Richmond-Baah/cnc-wireless-transfer/hardware/filexfer-pcb/fab/rev-B/README.md

# FileXfer rev B (short case): fab files (single board, not ordered)

Generated by `tools/gen_fab.py` from the committed `filexfer-pcb.kicad_pcb` (the master; don't reroute unless the design changes). Don't edit by hand. Design notes: `docs/revB-notes.md` §3d–3e; ordering checklist §5.

| File | Use |
|---|---|
| `filexfer-revB-gerbers.zip` | Upload to JLCPCB (same content as `gerbers/`) |
| `bom-RX-jlc.csv`, `cpl-RX-jlc.csv` | Receiver build (SD block fitted): 31 placements |
| `bom-TX-jlc.csv`, `cpl-TX-jlc.csv` | Transmitter build (no SD block): 23 placements |
| `filexfer-revB.step` | Board + all parts, DNP J1/J3/SW1 included (`kicad-cli pcb export step --subst-models`). J1, J3 and D2 are placeholder boxes (`tools/gen_fp.py`), not vendor geometry |
| `gerber-check.png` | Independent raster of F.Cu / B.Cu (+ drills), F/B mask openings + silk, drawn from the gerber/drill files only |

- 2 layers, 1.6 mm FR-4, 1 oz, 18.3 × 34.9 mm (+5.1 mm module antenna overhang). Min track 0.15 mm, clearance 0.127 mm, via 0.45/0.2 mm, all vias tented.
- **J1 (USB-A plug, top), J3 (microSD, bottom) and SW1 (BOOT, bottom) are DNP:** hand-soldered. All assembled parts are on the top.
- **Order with JLC edge rails joined by mouse-bites, not V-cut.** Pad copper is ≥ 0.29 mm from the long edges, and the rails carry the fiducials.
- Check JLC's placement preview for part rotations.
- Module: ESP32-S3-MINI-1-N8 only (IO35 used; no PSRAM variants).
- Test pads (bottom): TP1 +3V3, TP2 GND, TP3 BOOT. No UART pads: flash over USB download mode.
