Richmond-Baah/cnc-wireless-transfer/hardware/filexfer-pcb/docs/stage3-notes.md

# FileXfer PCB — Stage 3 notes (pre-checks + design decisions)

Legend: **[V]** checked in the named datasheet/drawing; **[U]** unverified.

## 0. Decisions from Stage 2 (user, 2026-11-09)
- One PCB and one case length for TX and RX (the case grows). No short TX variant.
- LDL1117S33R. XKB U217 plug is primary, Molex 48037 alternate; the plug is a DNP option so the first 10 can be hand-soldered.
- SD power defaults ON (pull-up on the switch's ON pin, driven by GPIO2).
- LED: WS2812B-2020 powered from VBUS 5 V; data through SN74AHCT1G125 (GPIO48 unchanged). **Superseded: SN74LV1T125, Molex alternate dropped (see stage4-notes.md).**
- Placement: plug → SD socket → module, antenna at the far tip, keep-out clear of plug/SD metal.

## 1. LDL1117 output capacitor / ESR with ceramics [V ST DocID030319 Rev 3 §6.2]
- "The control loop of the LDL1117 is designed to work with an output ceramic capacitor"; X5R/X7R suggested.
- Input ≥ 1 µF, close to VIN. Suggested combination: **1 µF in / 4.7 µF out**.
- The stability plan (min C / ESR region) is only plotted for VOUT = 5 V and 1.2 V (Fig 20/21); **3.3 V is not plotted** [U]. Ceramic 4.7 µF X7R sits inside both plotted regions.
- Design: CIN 4.7 µF (≥ 1 µF min), COUT 4.7 µF X7R 0603/0805 at the pins.

## 2. Plug PCB thickness / height
| | Molex 48037-2100 (SD-48037-003) [V] | XKB U217-041N-4BV81 (drawing A1) |
|---|---|---|
| Specified PCB thickness | **1.60 ± 0.05 mm** (note 3) | not stated |
| Shell | 12.00 × 4.50 mm, 17.80 long | 12.00 (12.90 over latches) × 4.50, 18.75 long |
| Tail plane (= PCB top) from shell top | 3.10 mm → shell **+3.10 / –1.40** about PCB top | 1.90 from one face, 2.60 from the other → **+2.60/–1.90 or +1.90/–2.60** [U which face] |
| Shell legs | 4.80 below shell top = 1.70 below PCB top (0.1 mm through 1.6 mm) | slots, leg length [U] |
| Mounting | overhangs the PCB edge (pads 2.75 mm from the edge) | overhangs the edge (layout) |

- **Board thickness: 1.6 mm** (matches Molex; nothing in the XKB drawing conflicts).
- Off-centre check: a host receptacle mates with the plug's own shell, so PCB thickness does not move the plug relative to the receptacle. What matters is the plug versus the case/board stack:
  - Molex: plug centre +0.85 mm above PCB top; stack envelope –1.6…+3.10 (centre +0.75) → **0.1 mm off-centre**.
  - XKB: plug centre +0.35 or –0.35 mm → **≤ 0.4 mm off-centre** relative to the stack (centre +0.75 → 0.4/1.1 mm). Not significant for mating; the case nose must be centred on the plug, not on the PCB. [U until the XKB 3D model/sample confirms the seating face]
- **XKB and Molex footprints differ** (pad positions/edge distance), so the alternate is not drop-in. Rev A uses the XKB footprint; the Molex needs its own footprint/rev.
- Height budget: max(plug +3.10, module 2.4, SD 2.0) + PCB 1.6 = **4.7 mm** stack against 7.3 mm inner.

## 3. Inrush versus USB 50 µC
Limit: ≤ 10 µF effective across VBUS at attach ↔ 50 µC at 5 V (Microchip, TI ISOUSB211, USB-IF Device Capacitance ECN; secondary sources). The USB-IF test method was not read [U].

Without soft-start (everything charged within µs through the LDO's 1.5–2 A current limit):
Q = 5 V·C_VBUS + 3.3 V·C_3V3 = 5 × 4.9 µF (4.7 LDO-in + 2 × 0.1) + 3.3 × (4.7 LDO-out + 10 module + 22 bulk + 1 + 1 EN + about 0.6 decoupling + SD rail about 4.8) ≈ 24.5 + 145 ≈ **170 µC → fails** (and the module's internal caps add more [U]).

To meet 50 µC without soft-start, C_3V3 ≤ (50 – 24.5)/3.3 ≈ 7.7 µF, which is below Espressif's ≥ 10 µF at the module. **So soft-start is needed.**

Design: a second **TPS22917** (U-SS) between the LDO output (3V3_LDO) and the main rail (+3V3), ON tied to its VIN, CT = 2.2 nF (CT → VIN), QOD open.
- tR at VIN 3.6 V = 1.6 µs/pF → **≈ 3.5 ms**; tON 3.8 µs/pF → about 8.4 ms [V TI SLVSDW8B §7.6].
- Ramp ≈ 0.8·3.3 V / 3.5 ms ≈ 0.75 V/ms → inrush into about 45 µF ≈ **34 mA** (≪ 100 mA unconfigured).
- Fast charge from VBUS = 5 × 4.9 + 3.3 × 4.7 ≈ **40 µC ≤ 50 µC** (nominal values; DC-bias derating only lowers it).
- Cost: +1 × TPS22917 (about $0.29 @100), Ron 80 mΩ → 32 mV at 0.4 A.
- The SD rail sits behind its own TPS22917 (CT 1 nF → tR ≈ 1.6 ms, QOD tied to VOUT for a fast power-cycle discharge) and is fed from +3V3, so it does not draw from VBUS directly.
- The ESP32 EN RC (10 k / 1 µF) is on +3V3 (after soft-start).

## 4. LED from VBUS
- WS2812B-2020 VDD = +5V (VBUS after polyfuse), 100 nF. SN74AHCT1G125: VCC +5V, OE̅ to GND, A = GPIO48 (10 k pull-down so the LED stays dark while the ESP boots), Y → 100 Ω → DIN.
- AHCT VCC range is 4.5–5.5 V; VBUS after the fuse and cable may sag below 4.5 V under Wi-Fi peaks → the buffer runs out of spec (VIH 2.0 V stays met; output high ≈ VCC) [U, bench].
- +5V caps (2 × 100 nF) are counted in C_VBUS above.

## 5. Tooling
- KiCad 10.0.4 (kicad-cli for ERC/netlist/DRC/export). The KiCad MCP server exposes project/pcb tools only, with no schematic editing, so the schematic is **generated by a script** from KiCad stock symbols (labels on pins) and checked with `kicad-cli sch erc` + netlist comparison.
- Stock symbols: RF_Module:ESP32-S3-MINI-1 (its footprint field is RF_Module:ESP32-S2-MINI-1, the same 15.4 × 20.5 land pattern; check against DS-M Fig 11-1 in Stage 4 [U]), Regulator_Linear:LD1117S33TR_SOT223 (pinout 1 GND, 2 VOUT/tab, 3 VIN = LDL1117 SOT-223 [V]), Power_Protection:USBLC6-2SC6, Power_Management:TPS22917DBV, LED:WS2812B-2020, 74xGxx:74AHCT1G125, Connector:Micro_SD_Card_Det1, Connector:USB_A, Device:Polyfuse, Connector:TestPoint.
- Stock footprints: Connector:Tag-Connect_TC2030-IDC-NL, Button_Switch_SMD:SW_SPST_TS-1088-xR020, LED_SMD:LED_WS2812B-2020_PLCC4_2.0x2.0mm, Connector_USB:USB_A_Molex_48037-2200_Horizontal (−2200, not −2100: check). **Custom footprints needed in Stage 4:** XKB U217 plug, SHOU HAN TF PUSH.

## 6. Stage 3 result
- `filexfer-pcb.kicad_sch` is generated by `tools/gen_sch.py` (edit the script, not the file). Every symbol pin is mapped to a net or NC, and the script refuses to write otherwise.
- **ERC: 0 errors, 0 warnings** (`kicad-cli sch erc`, KiCad 10.0.4). Fixes on the way: the SD switch's QOD goes to VOUT through R24 0 Ω (datasheet option 1; clears the open-collector↔power-out conflict), symbols snapped to grid, and the `filexfer` footprint library was added.
- Netlist reviewed: 36 named nets. GND has 55 pins (24 module + 31 others).
- 63 parts. Fit field: ALL / RX (SD block: U6, J3, C13–C15, R11–R24) / DNP (C1, C2, R3). The plug J1 keeps a DNP option for hand-soldering the first 10.
- Custom footprints (`tools/gen_fp.py` → `filexfer.pretty`), parsed and plotted by kicad-cli:
  - `microSD_SHOUHAN_TF_PUSH`: 9 contact pads (pad 9 = Cd) 0.70 × 1.60 at 1.10 pitch, 4 shell pads, 2 × Ø1.00 NPTH, from the vendor recommended layout. Body Y position derived from the top view [U].
  - `USB_A_Plug_XKB_U217-041N-4BV81`: 4 × 1.20 × 2.00 SMD (7.00 span), 2 × Ø1.00 NPTH at ±2.25, 2 × plated oval 1.60 × 4.00 / drill 1.00 × 2.50 at ±5.70. **The board-edge position and whether the shell's 1.90 mm drop needs a PCB notch are not in the drawing** [U]; resolve with the vendor 3D model before layout.
- Passive LCSC numbers are not assigned yet (Stage 4 BOM step); IC/connector LCSC numbers are in symbol fields.
- Firmware board-config proposal: `firmware/board_config.h` (Super Mini + rev A pin sets, SD SPI/SDMMC on the same pins, SD power/CD, board-ID ADC windows: TX 22k → 595 mV, RX 100k → 1650 mV).

## 7. Open items carried to Stage 4
1. XKB plug seating (mid-mount drop 1.90/2.60, notch?) from the 3D model; plug centre relative to the case nose.
2. ESP32-S3-MINI-1 footprint: the stock `RF_Module:ESP32-S2-MINI-1` must be checked against DS-M Fig 11-1 (65 pads, antenna keep-out).
3. CD switch polarity (TF PUSH Cd → shell?) and SD pull-up values [U].
4. D+ pull-up value (R3, DNP) per HDG [U].
5. Firmware: before SD power-off, set the SD GPIOs to input/low so the card is not back-powered through the ESD diodes.
