Richmond-Baah/cnc-wireless-transfer/session-ses_1e20.md

# Greeting

**Session ID:** ses_1e201b6c8ffeLG4DZr5js88S0P
**Created:** 5/12/2026, 9:01:04 PM
**Updated:** 5/12/2026, 9:26:03 PM

---

## User

hello

---

## Assistant (Build · GLM5 · 210.4s)

Hello! How can I help you today?

---

## User

in this codebase i have two folders for one project(receiver and transmitter), the other folder(esp32-s3...) is a whole project on its own, tell me about the various projects

---

## Assistant (Build · GLM5 · 55.0s)

**Tool: read**

**Input:**
```json
{
  "filePath": "C:\\Users\\3FARMATE ROBOTICS\\OneDrive\\Desktop\\WORKABLE_TRANSFER\\cnc-wireless-transfer"
}
```

**Output:**
```
<path>C:\Users\3FARMATE ROBOTICS\OneDrive\Desktop\WORKABLE_TRANSFER\cnc-wireless-transfer</path>
<type>directory</type>
<entries>
esp32-s3-pendrive-wireless-usb-disk-master/
receiver/
transmitter/

(3 entries)
</entries>
```

---

## User

0

---

## Assistant (Build · GLM5 · 931.4s)

**Tool: task**

**Input:**
```json
{
  "description": "Explore all project folders",
  "prompt": "Explore the codebase at C:\\Users\\3FARMATE ROBOTICS\\OneDrive\\Desktop\\WORKABLE_TRANSFER\\cnc-wireless-transfer thoroughly. There are 3 folders: receiver, transmitter, and esp32-s3-pendrive-wireless-usb-disk-master. For each folder, I need to understand:\n\n1. What the project does (purpose)\n2. Key source files and their roles\n3. Hardware target (e.g., ESP32, Arduino, etc.)\n4. Key libraries/frameworks used\n5. Communication protocols used (WiFi, BLE, serial, etc.)\n\nRead README files if they exist, read main source files, check platformio.ini or other config files for dependencies and board settings. Provide a comprehensive summary of each project.",
  "subagent_type": "explore"
}
```

**Output:**
```
task_id: ses_1e1f9ea36ffeFX9g0Z6r0ukhR6 (for resuming to continue this task if needed)

<task_result>
Now I have all the information needed. Here is the comprehensive summary of all three projects:

---

# Comprehensive Codebase Analysis

## Overview

This workspace is a **CNC Wireless G-Code Transfer System** -- a two-device solution that lets users wirelessly upload CNC G-code files from a browser to an ESP32-S3 acting as a USB flash drive connected to a CNC machine. A third project is a reference/inspiration project from ThingPulse.

---

## 1. TRANSMITTER

**Location:** `C:\Users\3FARMATE ROBOTICS\OneDrive\Desktop\WORKABLE_TRANSFER\cnc-wireless-transfer\transmitter\`

### Purpose
The Transmitter is the **user-facing hub**. It hosts a secure web interface (served from SPIFFS) where an operator can log in, upload G-code files, and have those files streamed over Wi-Fi to the Receiver unit. It acts as an HTTP proxy between the browser and the receiver, forwarding file data in chunks without buffering the entire file in RAM.

### Hardware Target
- **ESP32-S3** (specifically the "ESP32-S3 Super Mini" board)
- 4MB Flash, custom partition table (1.5MB app, 448KB SPIFFS for web assets)
- Onboard WS2812 RGB LED on **GPIO 48**

### Framework / Build System
- **ESP-IDF** (v5.0+), CMake-based
- Project name: `cnc_transmitter`
- Language: **C**

### Key Source Files and Their Roles

| File | Role |
|------|------|
| `main.c` | Entry point. Initializes NVS, LED, Wi-Fi, SPIFFS, web server, and the background receiver-status poller. |
| `wifi_manager.c/.h` | Wi-Fi initialization. Supports **SoftAP** (default, SSID `CNC_WIRELESS`), **Station**, or **AP+STA** mode. Reads/writes credentials to NVS (`wifi_cfg` namespace). Sets AP IP to `192.168.4.1`. Disables power management (`WIFI_PS_NONE`) for reliable AP beacons. |
| `web_server.c/.h` | HTTP server (port 80). Serves static assets from SPIFFS (login page, upload page, CSS, JS, MD5 library). Handles REST endpoints: `/login` (auth), `/upload` (file relay), `/status` (receiver state), `/config` (GET/POST Wi-Fi and auth settings), `/receiver_clear`, `/upload_cancel`, `/receiver_list`, `/debug`, `/ping`. |
| `file_transfer.c/.h` | Core transfer engine. Implements the 3-phase chunked protocol: (1) `POST /prepare` to receiver with filename/size/md5, (2) streams 8KB chunks via `POST /chunk` with `X-Chunk-Index` header, (3) `POST /finalize` with computed MD5. Computes MD5 on-the-fly using mbedTLS. Also runs a **background FreeRTOS task** that polls the receiver `/status` every 2 seconds and caches the result (mutex-protected) so the web UI `/status` endpoint never blocks. Target receiver IP: `192.168.4.150` (static). |
| `auth.c/.h` | Simple session-token authentication. Validates username/password from NVS (`sys_cfg` namespace), generates a 64-char hex token from `esp_random()`, and validates it on subsequent requests via `Authorization: Bearer <token>` header. |
| `led.c/.h` | WS2812 RGB LED controller. 5 states: IDLE (white breathing), UPLOADING (slow yellow blink), SENDING (fast yellow blink), SUCCESS (solid green 5s), ERROR (solid red 5s). Runs a dedicated FreeRTOS task. |

### Web UI Assets (SPIFFS)
| File | Role |
|------|------|
| `spiffs_data/index.html` | Login page with username/password form |
| `spiffs_data/upload.html` | Main upload interface with drag-and-drop, progress bar, cancel button, receiver status badge, file list, and settings modal |
| `spiffs_data/app.js` | Client-side JavaScript for login, file upload (with client-side MD5 via spark-md5), progress tracking, settings management |
| `spiffs_data/style.css` | CSS styling |
| `spiffs_data/spark-md5.min.js` | Client-side MD5 library for integrity verification in the browser |

### Communication Protocols
- **Wi-Fi** (802.11 b/g/n): SoftAP mode (default) or STA mode
- **HTTP** (REST API): Server on port 80 for browser clients; HTTP client for communicating with the receiver
- Custom 3-phase transfer protocol over HTTP: `/prepare` -> `/chunk` -> `/finalize`

### Key Libraries/Dependencies
- `espressif/led_strip` v3.0.0 (managed component for WS2812 via RMT)
- ESP-IDF components: `nvs_flash`, `esp_wifi`, `esp_http_server`, `esp_http_client`, `mbedtls` (MD5), `spiffs`, `cJSON`, `driver`

### Default Credentials
| Setting | Value |
|---------|-------|
| Wi-Fi SSID | `CNC_WIRELESS` |
| Wi-Fi Password | `cnc12345` |
| Web Username | `admin` |
| Web Password | `admin123` |
| Receiver IP | `192.168.4.150` |

---

## 2. RECEIVER

**Location:** `C:\Users\3FARMATE ROBOTICS\OneDrive\Desktop\WORKABLE_TRANSFER\cnc-wireless-transfer\receiver\`

### Purpose
The Receiver is the **CNC-facing device**. It connects to the Transmitter's Wi-Fi network, receives G-code files over HTTP, stores them on an SD card (via SPI), and simultaneously exposes that SD card as a **USB Mass Storage device** (USB flash drive) to the CNC machine. A strict state machine ensures mutual exclusion between Wi-Fi writes and USB reads to prevent data corruption.

### Hardware Target
- **ESP32-S3** ("ESP32-S3 Super Mini" board)
- 4MB Flash, custom partition table (24KB NVS, 2MB FAT storage partition, 1280KB app)
- MicroSD Card module connected via **SPI** (SPI3_HOST)
- Onboard WS2812 RGB LED on **GPIO 48**
- Native USB-C port (used as USB Device -- not for serial)

### SD Card SPI Pinout
| SD Pin | ESP32-S3 GPIO |
|--------|---------------|
| MOSI | GPIO 11 |
| MISO | GPIO 13 |
| SCK/CLK | GPIO 12 |
| CS/SS | GPIO 10 |
| VCC | 3.3V |
| GND | GND |

### Framework / Build System
- **ESP-IDF** (v5.0+), CMake-based
- Project name: `cnc_receiver`
- Language: **C**
- CPU frequency locked at **240 MHz**; power management **disabled** for Wi-Fi STA reliability

### Key Source Files and Their Roles

| File | Role |
|------|------|
| `main.c` | Entry point. Sequential initialization: NVS -> state machine -> LED -> SD card -> Wi-Fi (STA) -> file receiver HTTP server -> USB MSC. Includes a debug task that logs heap and USB mount status every 2s. |
| `wifi_manager.c/.h` | Wi-Fi STA initialization. Connects to the Transmitter's AP (or a shared router). Applies a **static IP of 192.168.4.150** (avoiding DHCP conflicts). Implements a fallback mechanism: alternates between custom SSID and default `CNC_WIRELESS` after max retries. |
| `file_receiver.c/.h` | HTTP server (port 80) implementing the receiver side of the transfer protocol. Endpoints: `/prepare` (accept file metadata, transition to RECEIVING, disconnect USB, open file), `/chunk` (write binary data to SD), `/finalize` (verify MD5, transition to FILE_READY, flush storage, reconnect USB), `/cancel`, `/status`, `/list`, `/download/*`, `/clear`, `/format`, `/settings` (accepts Wi-Fi config forwarded from transmitter). Also serves a minimal HTML file browser. |
| `state_machine.c/.h` | Thread-safe (mutex-protected) finite state machine with 5 states: `IDLE`, `RECEIVING`, `FILE_READY`, `USB_ACTIVE`, `ERROR`. Enforces valid transitions only. Directly drives LED state changes. |
| `sd_card.c/.h` | SD card initialization via SPI3_HOST with **multi-speed diagnostics** (tries 20MHz, 10MHz, 5MHz, 1MHz, 400kHz). Provides mount/unmount/remount functions. Global `current_sd_card` pointer shared with `usb_msc.c` for raw sector access. |
| `usb_msc.c/.h` | TinyUSB Mass Storage Class implementation. Exposes the SD card (or internal flash wear-leveling partition as fallback) as a USB flash drive. Implements all TinyUSB MSC callbacks: `read10`, `write10`, `capacity`, `test_unit_ready`, `inquiry`, `scsi`. Uses DMA-capable buffers for SD sector read/write. Provides `usb_msc_disconnect()`/`usb_msc_connect()` for safe USB re-enumeration during file transfers. USB device identifies as "Generic USB Flash Drive" (VID: 0x303A, PID: 0x4002). |
| `storage_manager.c/.h` | Fallback internal flash storage using wear-leveling (`esp_vfs_fat_spiflash_mount_rw_wl`). Used if no SD card is present. Provides mount/unmount/format functions. Reports base path as `/sdcard` (if SD mounted) or `/storage` (if using internal flash). Volume label set to `FILEXFER`. |
| `led.c/.h` | WS2812 RGB LED controller. 5 states: IDLE (white breathing), RECEIVING (blinking yellow), FILE_READY (solid green), USB_ACTIVE (solid blue), ERROR (solid red 5s then auto-transitions to IDLE). |

### State Machine Diagram
```
IDLE ──────────> RECEIVING ──────> FILE_READY
  ^                  |                  |
  |                  v                  v
  |               ERROR              USB_ACTIVE
  |                  |                  |
  └──────────────────┴──────────────────┘
```

### Communication Protocols
- **Wi-Fi** (802.11 b/g/n): Station mode only, connects to the Transmitter's AP
- **HTTP** (REST API): Server on port 80, accepts file transfers from the transmitter
- **USB Mass Storage** (USB 2.0 Full Speed): Exposes SD card as a standard USB flash drive to the CNC machine
- **SPI**: Communication with the MicroSD card module

### Key Libraries/Dependencies
- `espressif/led_strip` v3.0.0 (WS2812 RGB LED via RMT)
- `espressif/esp_tinyusb` v1.4.3 (USB MSC device support)
- ESP-IDF components: `nvs_flash`, `esp_wifi`, `esp_http_server`, `fatfs`, `wear_levelling`, `sdmmc`, `esp_tinyusb`, `mbedtls` (MD5), `cJSON`, `driver`

### Critical Configuration (sdkconfig.defaults)
- `CONFIG_TINYUSB_MSC_ENABLED=y` -- TinyUSB MSC enabled
- `CONFIG_FATFS_SECTOR_512=y` -- 512-byte sectors for CNC printer compatibility
- `CONFIG_FATFS_LONG_FILENAMES=y` -- Long filename support
- `CONFIG_ESP_CONSOLE_USB_SERIAL_JTAG_ENABLED=n` -- USB Serial/JTAG disabled to free USB for TinyUSB MSC
- `CONFIG_ESP_DEFAULT_CPU_FREQ_MHZ_240=y` -- 240MHz for stable Wi-Fi
- Power management disabled (light sleep breaks Wi-Fi STA)

---

## 3. ESP32-S3 PENDRIVE WIRELESS USB DISK MASTER

**Location:** `C:\Users\3FARMATE ROBOTICS\OneDrive\Desktop\WORKABLE_TRANSFER\cnc-wireless-transfer\esp32-s3-pendrive-wireless-usb-disk-master\`

### Purpose
This is a **reference/inspiration project** from ThingPulse (commercial product: "Pendrive S3"). It implements a wireless USB disk: when plugged into a computer, it mounts as a regular memory stick AND starts a Wi-Fi access point with a web server, allowing users to access, upload, and delete files on the storage via a browser. The CNC transfer system appears to have been inspired by and adapted from this project.

### Hardware Target
- **ThingPulse Pendrive S3** (ESP32-S3 with 128MB flash, custom hardware with integrated SD card via MMC)
- Board: `esp32-s3-devkitc-1`

### Framework / Build System
- **PlatformIO** (not ESP-IDF directly)
- **Arduino framework** (not ESP-IDF native)
- Language: **C++**
- Custom platform fork: `https://github.com/cziter15/platform-espressif32.git`
- 4MB Flash, `min_spiffs` partition scheme

### Key Source Files and Their Roles

| File | Role |
|------|------|
| `src/main.cpp` | Arduino setup/loop. Initializes SD_MMC (4-bit mode on specific GPIOs: CLK=36, CMD=35, D0-D3=37/38/33/34), configures USB MSC with read/write/start-stop callbacks, starts USB, then calls `initWebServer()`. Main loop handles web server client requests and updates the NeoPixel LED (red for host writes, green for host reads, brown for both). |
| `src/fileserver.h` | Complete web server implementation. Uses Arduino `WebServer` on port 80. Features: file listing (`/api/list`), disk info (`/api/disk`), settings management (`/api/settings` GET/POST), file upload (`/upload`), file delete (`/delete`), and generic file serving from SD card. Settings (Wi-Fi mode, AP/STA credentials) stored in SPIFFS as JSON. Supports AP, STA, and AP+STA modes. **Restarts the device after file uploads** to make changes visible to the USB host. |
| `web/index.html` | Web interface for file browsing/upload |
| `web/settings.html` | Settings page for Wi-Fi configuration |
| `web/favicon.ico` | Favicon |

### Communication Protocols
- **Wi-Fi** (802.11 b/g/n): AP mode (default SSID: `wireless-usb-disk`, password: `12345678`), STA, or AP+STA
- **HTTP**: Web server on port 80 for file management
- **USB Mass Storage**: Exposes SD card as USB flash drive to host computer
- **SDMMC** (4-bit mode): High-speed SD card access (not SPI like the receiver)

### Key Libraries/Dependencies
- `USB.h` / `USBMSC.h` -- Arduino USB MSC library
- `SD_MMC.h` -- Arduino SD card MMC library
- `WiFi.h` / `WiFiAP.h` -- Arduino Wi-Fi libraries
- `WebServer.h` -- Arduino HTTP server
- `SPIFFS.h` -- Arduino SPIFFS for settings storage
- `bblanchon/ArduinoJson@^7.1.0` -- JSON parsing/serialization

### Default Credentials
| Setting | Value |
|---------|-------|
| AP SSID | `wireless-usb-disk` |
| AP Password | `12345678` |

---

## Comparative Summary

| Feature | Transmitter | Receiver | Pendrive S3 (Reference) |
|---------|------------|----------|------------------------|
| **Framework** | ESP-IDF (C) | ESP-IDF (C) | Arduino/PlatformIO (C++) |
| **Role** | Web UI hub + file proxy | File storage + USB drive to CNC | Standalone wireless USB disk |
| **Wi-Fi Mode** | SoftAP (default) / AP+STA | STA only | AP / STA / AP+STA |
| **HTTP Server** | Yes (full REST API) | Yes (transfer protocol + file browser) | Yes (file browser + upload) |
| **USB MSC** | No | Yes (TinyUSB, SD via SPI) | Yes (Arduino USBMSC, SD via MMC) |
| **SD Card** | None | Yes, SPI mode (SPI3_HOST) | Yes, MMC mode (4-bit) |
| **Internal Flash Storage** | SPIFFS (web assets) | FAT wear-leveling (fallback storage, 2MB) | Not used for data |
| **Authentication** | Session token (Bearer) | None | None |
| **MD5 Verification** | Yes (mbedTLS, on-the-fly) | Yes (mbedTLS, on-the-fly) | No |
| **State Machine** | Simple LED states | Full FSM with mutual exclusion | None |
| **LED** | WS2812 (5 states) | WS2812 (5 states) | NeoPixel (read/write indicators) |
| **File Transfer Protocol** | Custom 3-phase chunked HTTP | Receiver side of same protocol | Direct upload + device restart |
| **Chunked Streaming** | Yes (8KB chunks) | Yes (16KB buffer) | No (full file buffer) |
| **Cancel Support** | Yes (abort flag + receiver /cancel) | Yes (/cancel endpoint) | No |
| **Settings Sync** | Forwards to receiver before saving local | Accepts from transmitter | Local SPIFFS only |

### Key Architectural Differences from Reference Project

The CNC system significantly improves upon the Pendrive S3 reference design:

1. **No restart required**: The Pendrive S3 restarts the entire device after each file upload to make changes visible to the USB host. The CNC Receiver instead disconnects/reconnects USB on-the-fly (`tud_disconnect()`/`tud_connect()`), preserving network connectivity.

2. **Chunked streaming**: Instead of buffering entire files in RAM, the CNC system uses an 8KB chunked protocol, enabling transfer of files much larger than available heap memory.

3. **MD5 integrity verification**: Both transmitter and receiver compute MD5 checksums on-the-fly during transfer, verifying end-to-end integrity. The Pendrive S3 has no such verification.

4. **State machine with mutual exclusion**: The receiver enforces strict USB/Wi-Fi mutual exclusion -- USB is disconnected during file writes and reconnected after verification, preventing the CNC machine from reading partially-written data.

5. **Authentication**: The transmitter implements session-token authentication, preventing unauthorized access to the CNC file transfer system.

6. **ESP-IDF native**: The transmitter and receiver use ESP-IDF (C) rather than Arduino (C++), providing lower-level control over TinyUSB, SPI, and the Wi-Fi stack -- essential for the simultaneous Wi-Fi + USB MSC operation with state machine enforcement.
</task_result>
```

---

## Assistant (Build · GLM5 · 107.3s)

Here's a summary of the 3 projects in your workspace:

---

### 1. **Transmitter** — Web UI Hub + File Relay
- **Role**: User-facing device. Hosts a secure web interface (login, drag-and-drop upload) and streams G-code files over Wi-Fi to the Receiver in 8KB chunks.
- **Hardware**: ESP32-S3 Super Mini, WS2812 LED (GPIO 48)
- **Framework**: ESP-IDF (C), SPIFFS for web assets
- **Wi-Fi**: SoftAP mode (SSID: `CNC_WIRELESS`, IP: `192.168.4.1`)
- **Features**: Session-token auth, on-the-fly MD5 verification, background receiver status polling, REST API (`/login`, `/upload`, `/status`, `/config`, etc.)

### 2. **Receiver** — CNC-Facing USB Flash Drive
- **Role**: Connects to the Transmitter's Wi-Fi, receives G-code files over HTTP, stores them on an SD card (SPI), and exposes that SD card as a **USB Mass Storage** device to the CNC machine.
- **Hardware**: ESP32-S3 Super Mini, MicroSD via SPI (MOSI=11, MISO=13, SCK=12, CS=10), WS2812 LED
- **Framework**: ESP-IDF (C), TinyUSB for MSC, FAT filesystem
- **Wi-Fi**: STA only, static IP `192.168.4.150`
- **Features**: 5-state FSM enforcing USB/Wi-Fi mutual exclusion (disconnects USB during writes, reconnects after), MD5 verification, fallback internal flash storage, cancel support

### 3. **ESP32-S3 Pendrive Wireless USB Disk** — Reference Project (ThingPulse)
- **Role**: A standalone wireless USB disk — mounts as a flash drive on a PC *and* serves a web UI for file upload/management over Wi-Fi.
- **Hardware**: ThingPulse Pendrive S3 (ESP32-S3, 128MB flash, SD via MMC 4-bit)
- **Framework**: Arduino/PlatformIO (C++)
- **Wi-Fi**: AP/STA/AP+STA
- **Key difference**: Requires a **full device restart** after each upload (no hot USB reconnect), no MD5 verification, no chunked streaming, no state machine

---

**How they relate**: The Transmitter + Receiver are your custom CNC wireless transfer system, purpose-built to reliably stream G-code to CNC machines. The Pendrive S3 project was the inspiration/reference, but your system improves on it significantly — chunked streaming, MD5 integrity, USB hot-reconnect without restart, and a strict state machine for data safety.

---
