Richmond-Baah/cnc-wireless-transfer/hardware/filexfer-pcb/docs/img/placement-2d.png

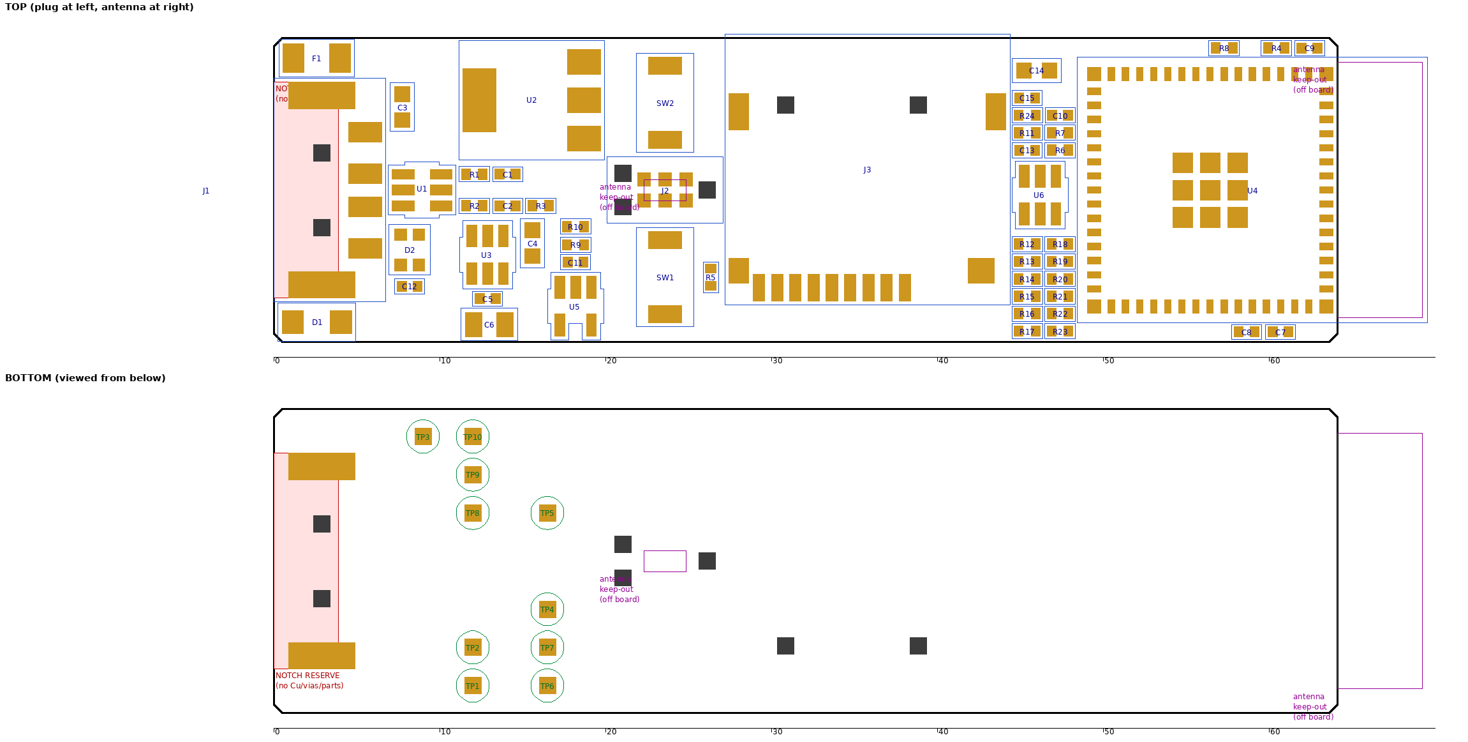
hardware/filexfer-pcb/docs/img/placement-2d.png
