Richmond-Baah/cnc-wireless-transfer/hardware/filexfer-pcb/docs/img/placement-3d-iso.png

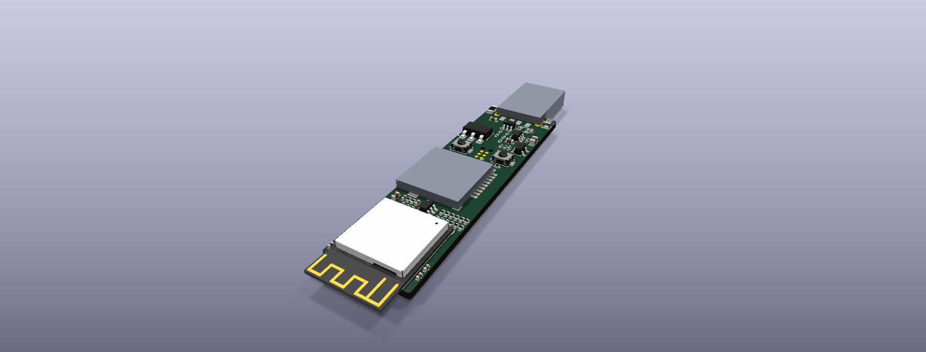
hardware/filexfer-pcb/docs/img/placement-3d-iso.png
