Richmond-Baah/cnc-wireless-transfer/hardware/filexfer-pcb/docs/img/revB-feasibility-sketch.png

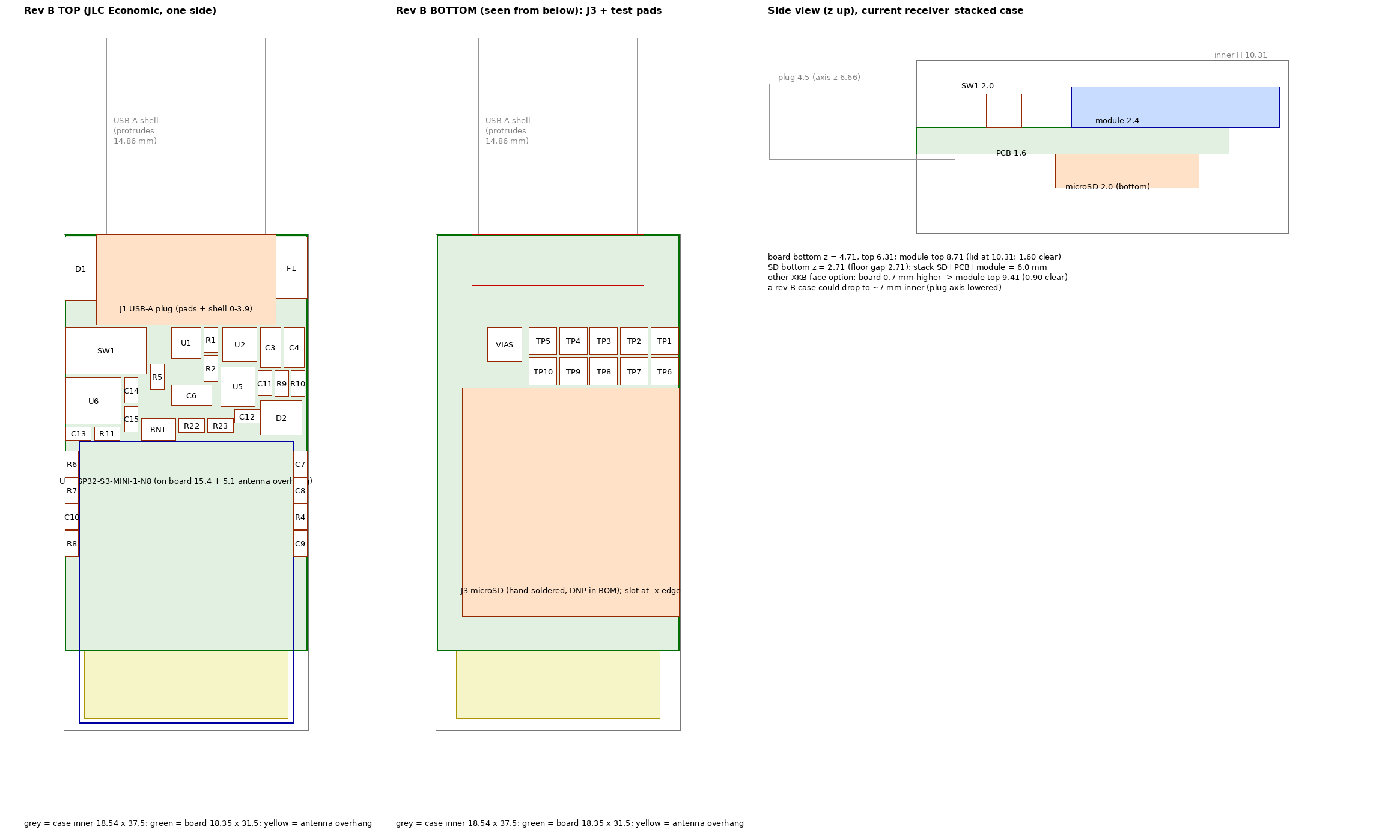
hardware/filexfer-pcb/docs/img/revB-feasibility-sketch.png
