Richmond-Baah/cnc-wireless-transfer/hardware/filexfer-pcb/docs/img/revB-placement-2d.png

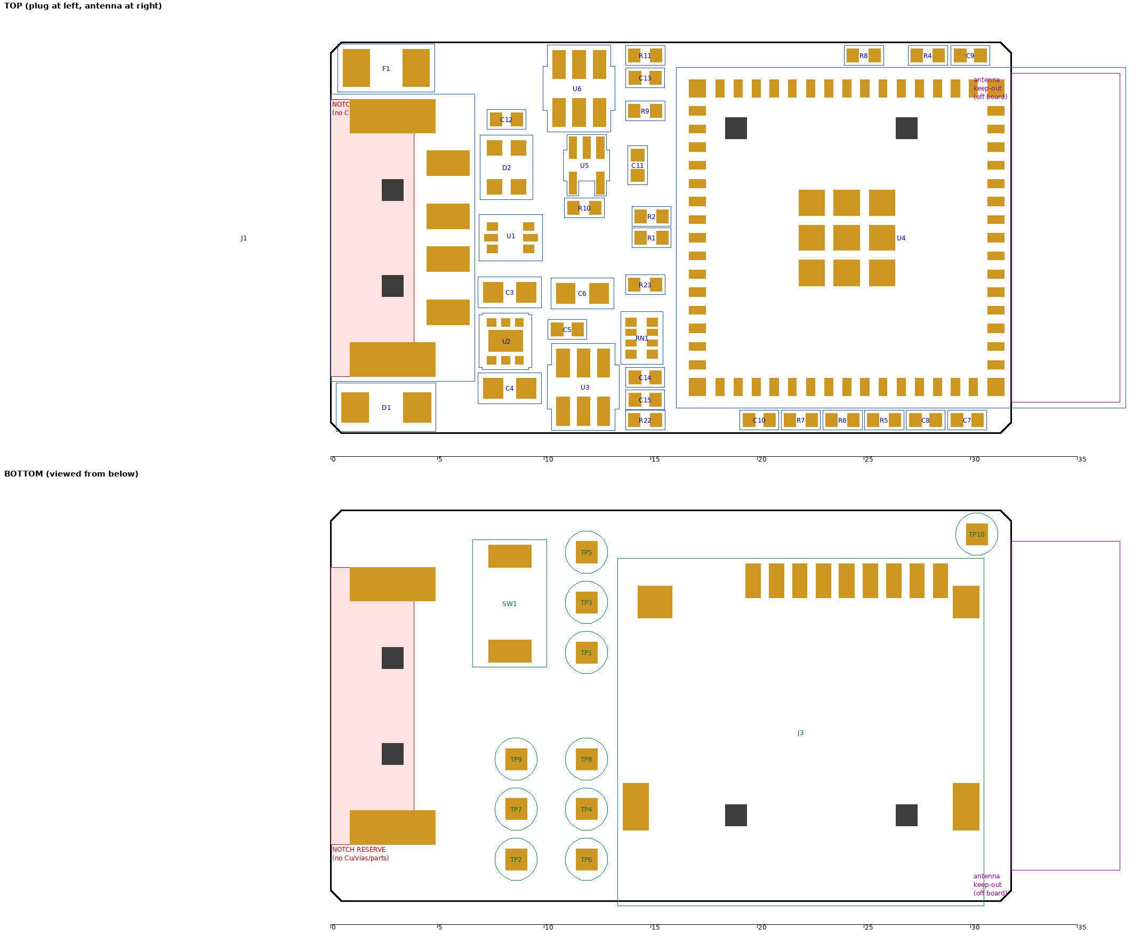
hardware/filexfer-pcb/docs/img/revB-placement-2d.png
