Richmond-Baah/cnc-wireless-transfer/hardware/filexfer-pcb/docs/img/revB-route-attempt-2layer.png

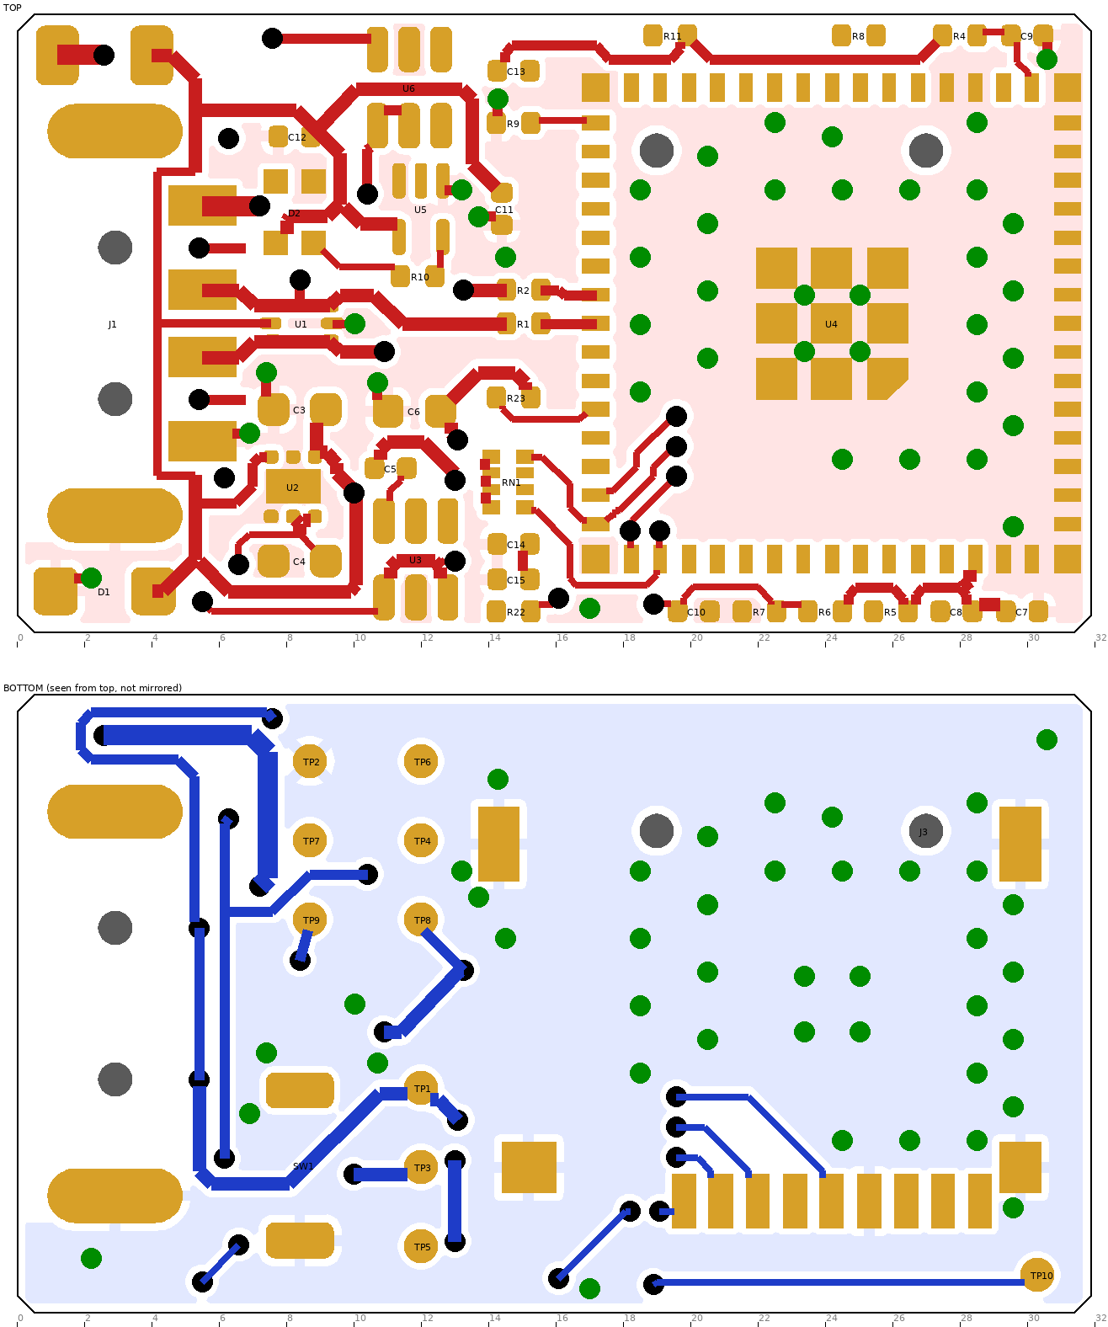
hardware/filexfer-pcb/docs/img/revB-route-attempt-2layer.png
