Richmond-Baah/cnc-wireless-transfer/hardware/filexfer-pcb/docs/img/revB-routed-2d.png

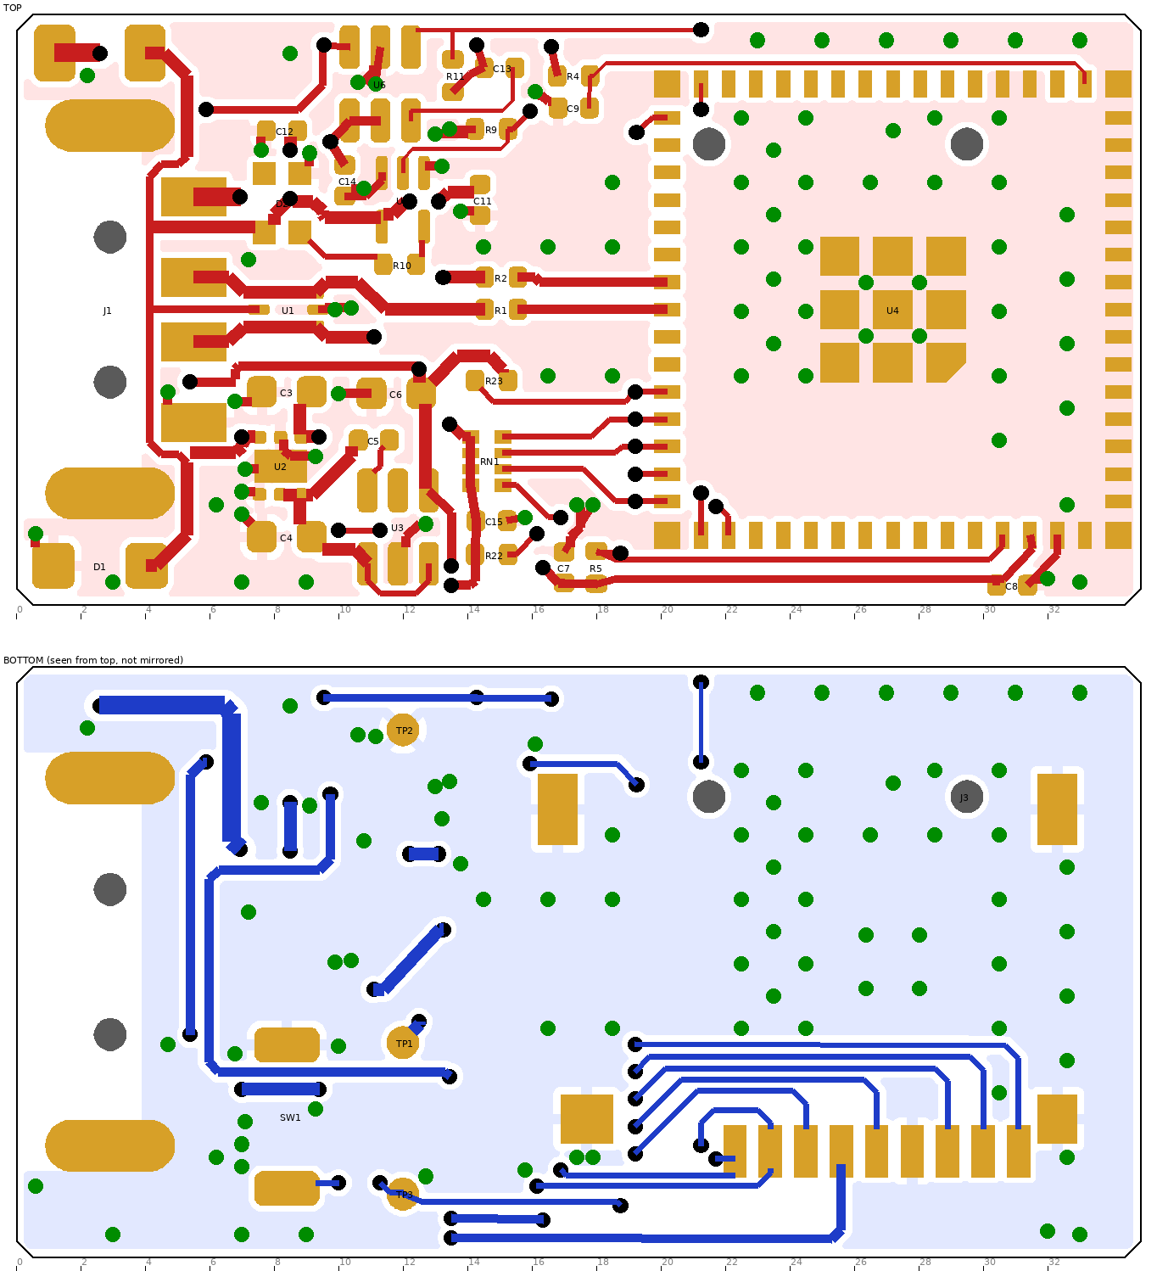
hardware/filexfer-pcb/docs/img/revB-routed-2d.png
