Richmond-Baah/cnc-wireless-transfer/hardware/filexfer-pcb/docs/img/revB-routed-3d-iso.png

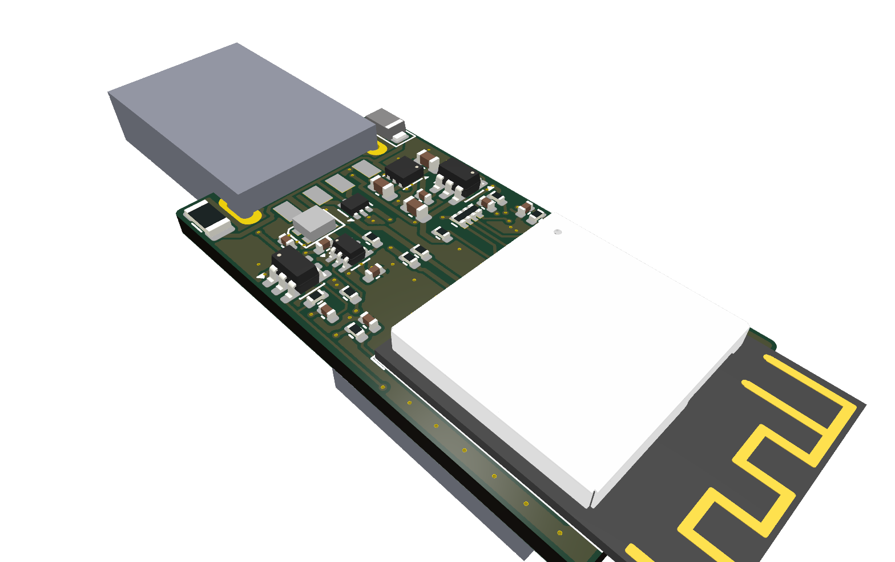
hardware/filexfer-pcb/docs/img/revB-routed-3d-iso.png
