Richmond-Baah/cnc-wireless-transfer/hardware/filexfer-pcb/docs/img/revB-routed-3d-top.png

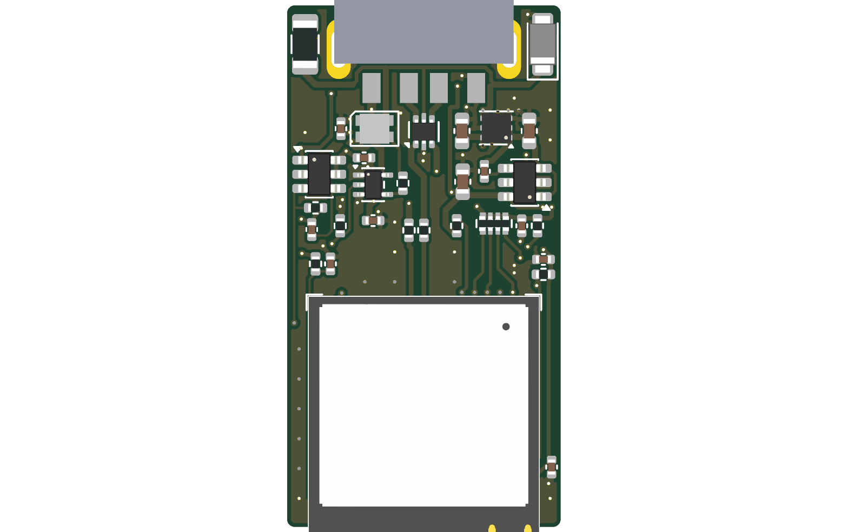
hardware/filexfer-pcb/docs/img/revB-routed-3d-top.png
