Richmond-Baah/cnc-wireless-transfer/hardware/filexfer-pcb/docs/img/routed-copper.png

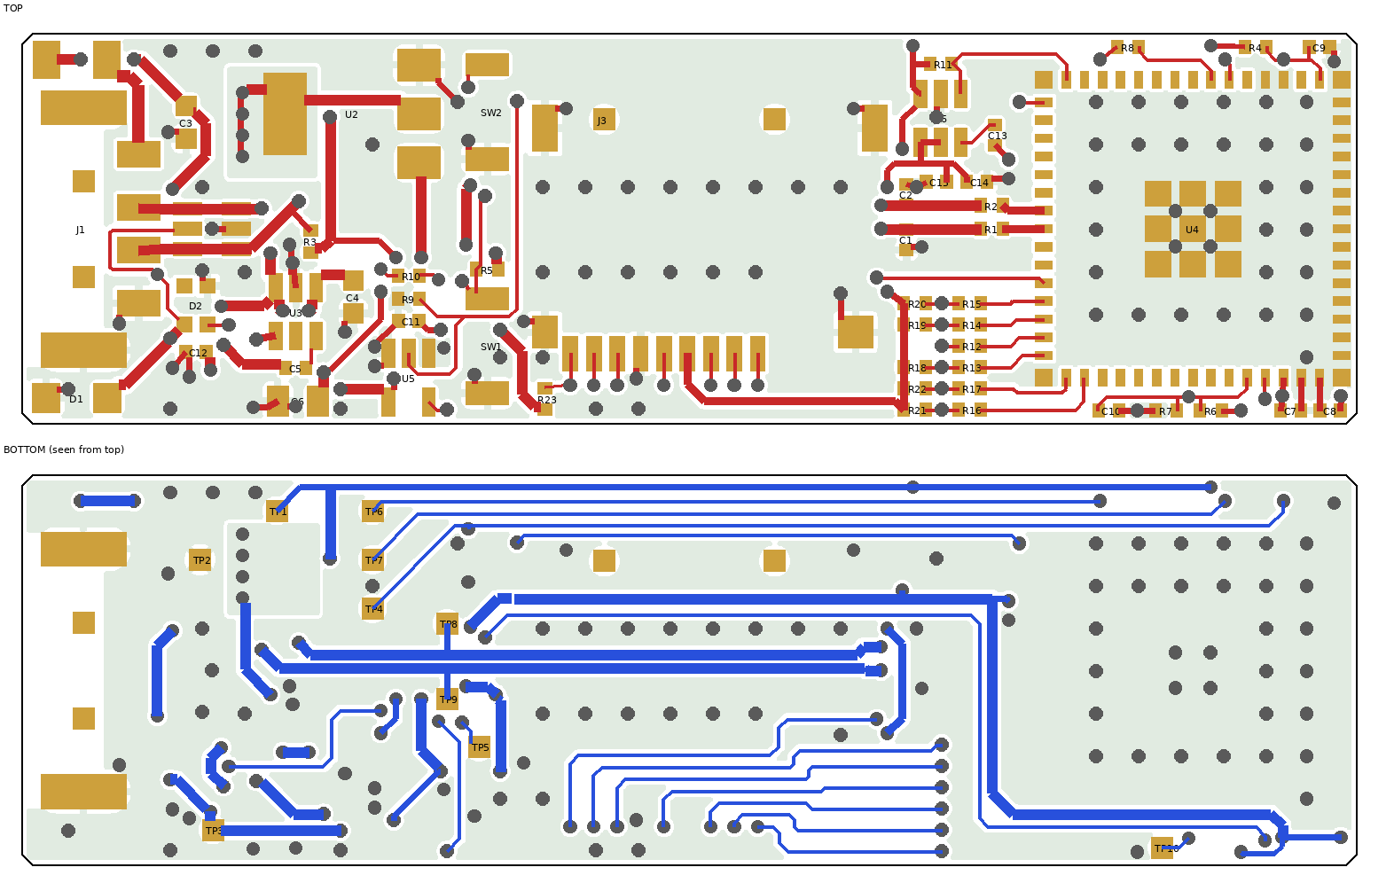
hardware/filexfer-pcb/docs/img/routed-copper.png
