Richmond-Baah/cnc-wireless-transfer/hardware/filexfer-pcb/docs/img/schematic-revA.png

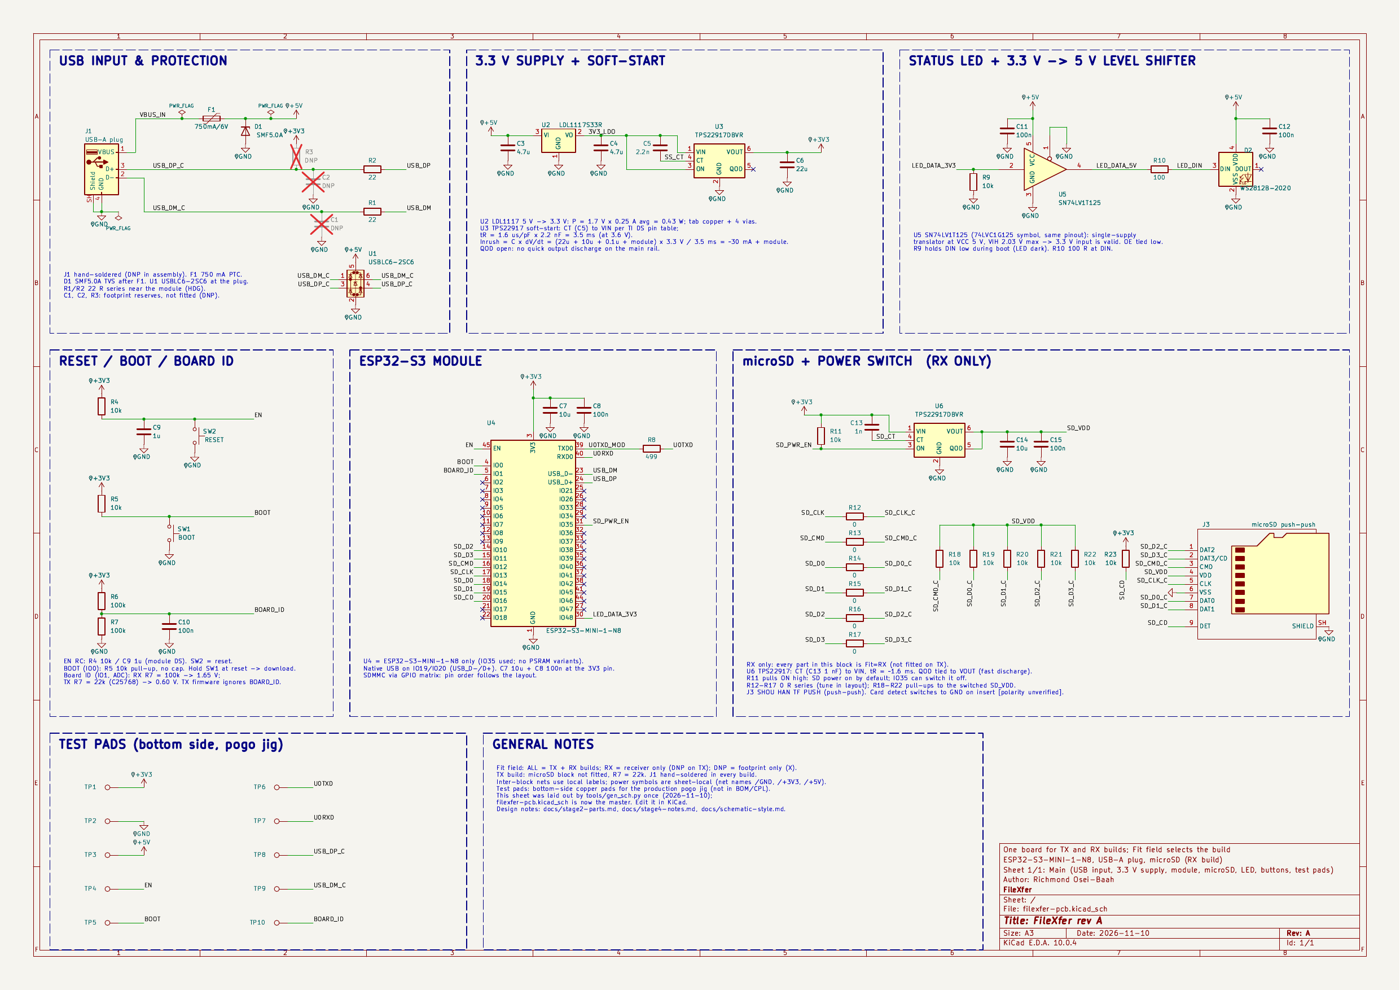
hardware/filexfer-pcb/docs/img/schematic-revA.png
