Richmond-Baah/cnc-wireless-transfer/hardware/filexfer-pcb/docs/img/schematic-revB.png

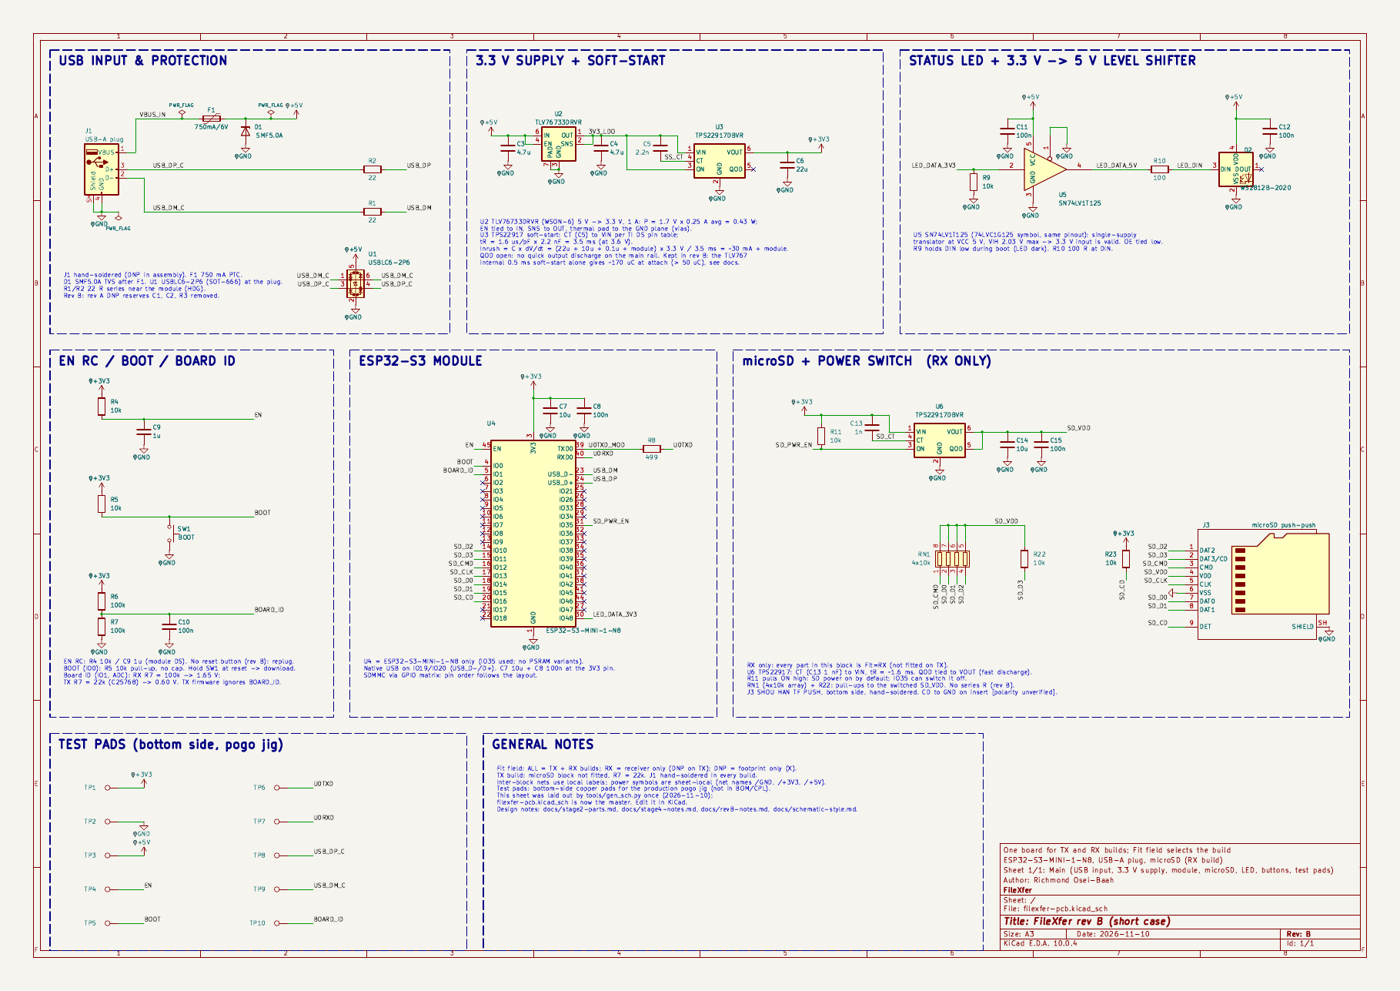
hardware/filexfer-pcb/docs/img/schematic-revB.png
