Richmond-Baah/cnc-wireless-transfer/hardware/filexfer-pcb/fab/rev-B/gerber-check.png

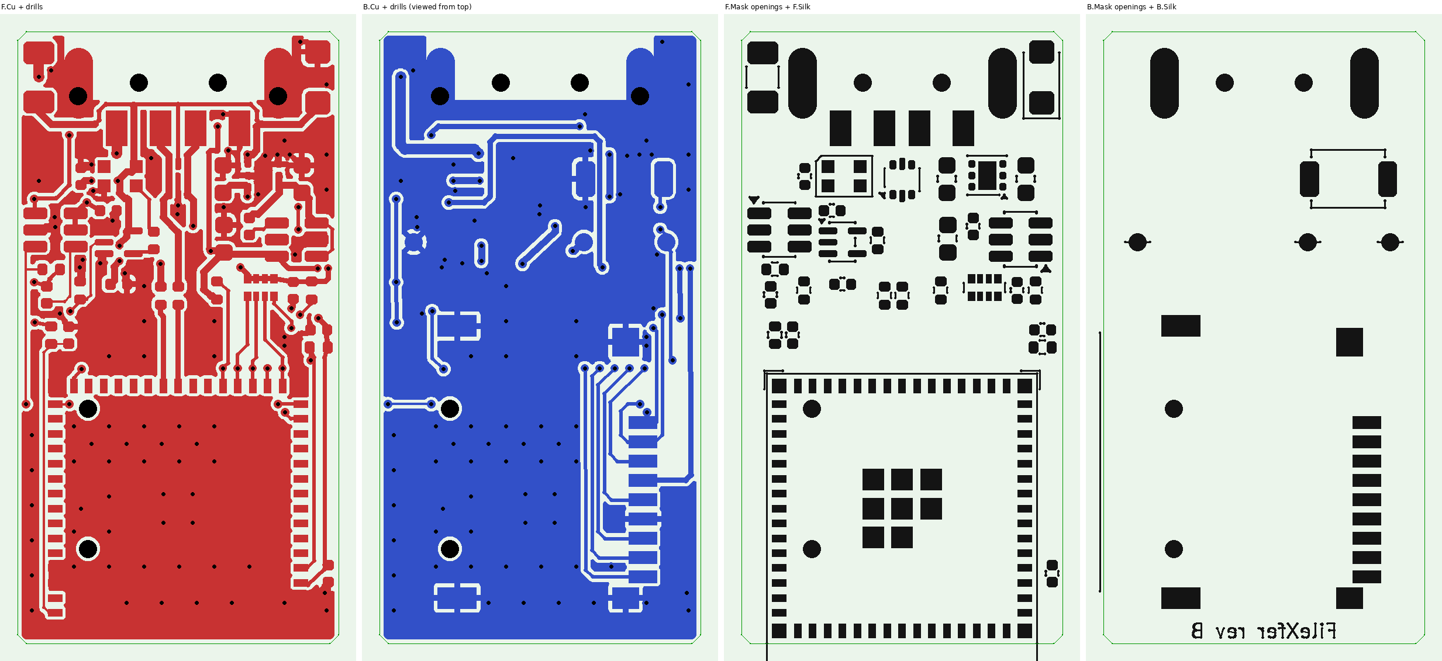
hardware/filexfer-pcb/fab/rev-B/gerber-check.png
