Richmond-Baah/cnc-wireless-transfer/hardware/filexfer-pcb/fab/rev-B/bom-RX-jlc.csv

Comment | Designator | Footprint | LCSC Part # | MPN | Qty
4.7u | C3,C4 | C_0603_1608Metric | C19666 | CL10A475KO8NNNC | 2
2.2n | C5 | C_0402_1005Metric | C1531 | 0402B222K500NT | 1
22u | C6 | C_0603_1608Metric | C59461 | CL10A226MQ8NRNC | 1
10u | C7,C14 | C_0402_1005Metric | C15525 | CL05A106MQ5NUNC | 2
100n | C8,C11,C12,C15 | C_0402_1005Metric | C1525 | CL05B104KO5NNNC | 4
1u | C9 | C_0402_1005Metric | C52923 | CL05A105KA5NQNC | 1
1n | C13 | C_0402_1005Metric | C1523 | 0402B102K500NT | 1
SMF5.0A | D1 | D_SMF | C2759874 | SMF5.0A (Leiditech) | 1
WS2812B-2020 | D2 | LED_WS2812B-2020_PLCC4_2.0x2.0mm | C52917434 | WS2812B-2020-V6 | 1
750mA/6V | F1 | Fuse_1206_3216Metric | C883127 | BSMD1206-075-6V | 1
22 | R1,R2 | R_0402_1005Metric | C25092 | 0402WGF220JTCE | 2
10k | R4,R5,R9,R11,R22,R23 | R_0402_1005Metric | C25744 | 0402WGF1002TCE | 6
100 | R10 | R_0402_1005Metric | C25076 | 0402WGF1000TCE | 1
4x10k | RN1 | R_Array_Convex_4x0402 | C25725 | 4D02WGJ0103TCE | 1
USBLC6-2P6 | U1 | SOT-666 | C15999 | USBLC6-2P6 | 1
TLV76733DRVR | U2 | WSON-6-1EP_2x2mm_P0.65mm_EP1x1.6mm | C2848334 | TLV76733DRVR | 1
TPS22917DBVR | U3,U6 | SOT-23-6 | C2681320 | TPS22917DBVR | 2
ESP32-S3-MINI-1-N8 | U4 | ESP32-S3-MINI-1 | C2913206 | ESP32-S3-MINI-1-N8 | 1
SN74LV1T125 | U5 | SOT-353_SC-70-5 | C75925 | SN74LV1T125DCKR | 1
