Richmond-Baah/cnc-wireless-transfer/hardware/filexfer-pcb/3dmodels/LED_WS2812B-2020_PLCC4_2.0x2.0mm.step

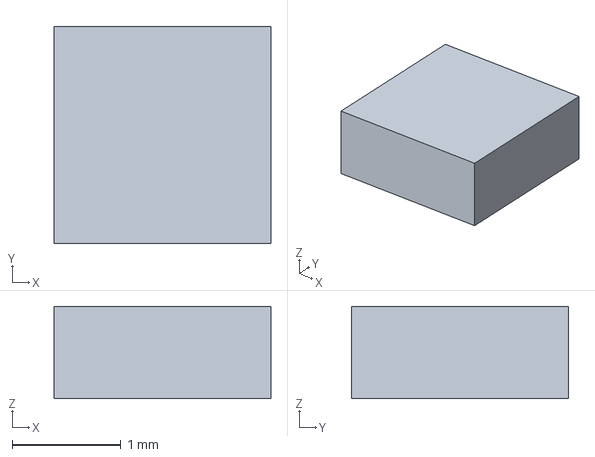
[picture p21: CAD file, 2026-11-10]
hardware/filexfer-pcb/3dmodels/LED_WS2812B-2020_PLCC4_2.0x2.0mm.step
2.00 x 2.00 x 0.85 mm
