Richmond-Baah/cnc-wireless-transfer/hardware/filexfer-pcb/fab/rev-B/filexfer-revB.step

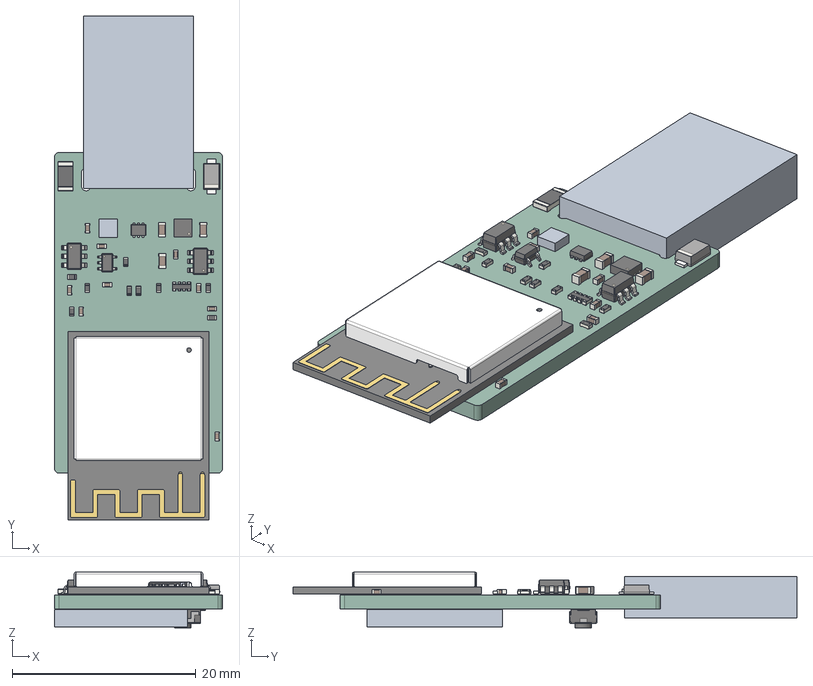
[picture p22: CAD file, 2026-11-10]
hardware/filexfer-pcb/fab/rev-B/filexfer-revB.step
18.3 x 54.9 x 6.08 mm
R_0402_1005Metric x 9
WSON_6_1EP_2x2mm_P065mm_EP1x16mm
USB_A_Plug_XKB_U217-041N-4BV81
R_Array_Convex_4x0402
LED_WS2812B-2020_PLCC4_2.0x2.0mm
C_0603_1608Metric x 3
D_SMF
C_0402_1005Metric x 9
C0201_20210301.STEP^C0201_20210301.STEP_Submodel-C0201_part_ DesignRootModel_ESP32-S3-MINI-1_V1(2)_ESP32-S3-MINI-1_V1 x 14
L0201_20210301.STEP^L0201_20210301.STEP_Submodel-L0201_part_ DesignRootModel_ESP32-S3-MINI-1_V1(2)_ESP32-S3-MINI-1_V1 x 3
R0201_20210301.STEP^R0201_20210301.STEP_Submodel-R0201_part_ DesignRootModel_ESP32-S3-MINI-1_V1(2)_ESP32-S3-MINI-1_V1 x 3
C0402_20210301.STEP^C0402_20210301.STEP_Submodel-C0402_part_ DesignRootModel_ESP32-S3-MINI-1_V1(2)_ESP32-S3-MINI-1_V1
ESP32-S3_20210301.STEP^ESP32-S3_20210301.STEP_Submodel-QFN56_0P4_7_ part_DesignRootModel_ESP32-S3-MINI-1_V1(2)_ESP32-S3-MINI-1_V1
trace_4^Submodel-MINI-ANT-TYPES-H_433354944_part_DesignRootModel_ ESP32-S3-MINI-1_V1(2)_ESP32-S3-MINI-1_V1
trace_1^Submodel-MINI-ANT-TYPES-H_433354944_part_DesignRootModel_ ESP32-S3-MINI-1_V1(2)_ESP32-S3-MINI-1_V1
DFN1006.STEP^DFN1006.STEP_Submodel-SOD882_part_DesignRootModel_ ESP32-S3-MINI-1_V1(2)_ESP32-S3-MINI-1_V1
XTAL3225_20210301.STEP^XTAL3225_20210301.STEP_Submodel-XTAL3225_part_ DesignRootModel_ESP32-S3-MINI-1_V1(2)_ESP32-S3-MINI-1_V1
uid__4^DesignRootModel_ESP32-S3-MINI-1_V1(2)_ESP32-S3-MINI-1_V1
uid__4-0^DesignRootModel_ESP32-S3-MINI-1_V1(2)_ESP32-S3-MINI-1_V1
uid__4-1^DesignRootModel_ESP32-S3-MINI-1_V1(2)_ESP32-S3-MINI-1_V1
uid__4-2^DesignRootModel_ESP32-S3-MINI-1_V1(2)_ESP32-S3-MINI-1_V1
uid__4-3^DesignRootModel_ESP32-S3-MINI-1_V1(2)_ESP32-S3-MINI-1_V1
uid__4-4^DesignRootModel_ESP32-S3-MINI-1_V1(2)_ESP32-S3-MINI-1_V1
uid__4-5^DesignRootModel_ESP32-S3-MINI-1_V1(2)_ESP32-S3-MINI-1_V1
uid__4-6^DesignRootModel_ESP32-S3-MINI-1_V1(2)_ESP32-S3-MINI-1_V1
uid__4-7^DesignRootModel_ESP32-S3-MINI-1_V1(2)_ESP32-S3-MINI-1_V1
uid__4-8^DesignRootModel_ESP32-S3-MINI-1_V1(2)_ESP32-S3-MINI-1_V1
uid__4-9^DesignRootModel_ESP32-S3-MINI-1_V1(2)_ESP32-S3-MINI-1_V1
uid__4-10^DesignRootModel_ESP32-S3-MINI-1_V1(2)_ESP32-S3-MINI-1_V1
uid__4-11^DesignRootModel_ESP32-S3-MINI-1_V1(2)_ESP32-S3-MINI-1_V1
uid__4-12^DesignRootModel_ESP32-S3-MINI-1_V1(2)_ESP32-S3-MINI-1_V1
uid__4-13^DesignRootModel_ESP32-S3-MINI-1_V1(2)_ESP32-S3-MINI-1_V1
uid__4-14^DesignRootModel_ESP32-S3-MINI-1_V1(2)_ESP32-S3-MINI-1_V1
uid__4-15^DesignRootModel_ESP32-S3-MINI-1_V1(2)_ESP32-S3-MINI-1_V1
uid__4-16^DesignRootModel_ESP32-S3-MINI-1_V1(2)_ESP32-S3-MINI-1_V1
uid__4-17^DesignRootModel_ESP32-S3-MINI-1_V1(2)_ESP32-S3-MINI-1_V1
uid__4-30^DesignRootModel_ESP32-S3-MINI-1_V1(2)_ESP32-S3-MINI-1_V1
uid__4-38^DesignRootModel_ESP32-S3-MINI-1_V1(2)_ESP32-S3-MINI-1_V1
uid__4-39^DesignRootModel_ESP32-S3-MINI-1_V1(2)_ESP32-S3-MINI-1_V1
uid__4-44^DesignRootModel_ESP32-S3-MINI-1_V1(2)_ESP32-S3-MINI-1_V1
uid__4-45^DesignRootModel_ESP32-S3-MINI-1_V1(2)_ESP32-S3-MINI-1_V1
uid__4-49^DesignRootModel_ESP32-S3-MINI-1_V1(2)_ESP32-S3-MINI-1_V1
uid__4-55^DesignRootModel_ESP32-S3-MINI-1_V1(2)_ESP32-S3-MINI-1_V1
uid__4-56^DesignRootModel_ESP32-S3-MINI-1_V1(2)_ESP32-S3-MINI-1_V1
uid__4-65^DesignRootModel_ESP32-S3-MINI-1_V1(2)_ESP32-S3-MINI-1_V1
uid__4-69^DesignRootModel_ESP32-S3-MINI-1_V1(2)_ESP32-S3-MINI-1_V1
uid__4-70^DesignRootModel_ESP32-S3-MINI-1_V1(2)_ESP32-S3-MINI-1_V1
uid__4-71^DesignRootModel_ESP32-S3-MINI-1_V1(2)_ESP32-S3-MINI-1_V1
uid__4-72^DesignRootModel_ESP32-S3-MINI-1_V1(2)_ESP32-S3-MINI-1_V1
uid__4-73^DesignRootModel_ESP32-S3-MINI-1_V1(2)_ESP32-S3-MINI-1_V1
uid__4-76^DesignRootModel_ESP32-S3-MINI-1_V1(2)_ESP32-S3-MINI-1_V1
uid__4-77^DesignRootModel_ESP32-S3-MINI-1_V1(2)_ESP32-S3-MINI-1_V1
uid__4-86^DesignRootModel_ESP32-S3-MINI-1_V1(2)_ESP32-S3-MINI-1_V1
uid__4-92^DesignRootModel_ESP32-S3-MINI-1_V1(2)_ESP32-S3-MINI-1_V1
uid__4-93^DesignRootModel_ESP32-S3-MINI-1_V1(2)_ESP32-S3-MINI-1_V1
uid__4-94^DesignRootModel_ESP32-S3-MINI-1_V1(2)_ESP32-S3-MINI-1_V1
uid__4-99^DesignRootModel_ESP32-S3-MINI-1_V1(2)_ESP32-S3-MINI-1_V1
uid__4-100^DesignRootModel_ESP32-S3-MINI-1_V1(2)_ESP32-S3-MINI-1_V1
uid__4-102^DesignRootModel_ESP32-S3-MINI-1_V1(2)_ESP32-S3-MINI-1_V1
uid__4-103^DesignRootModel_ESP32-S3-MINI-1_V1(2)_ESP32-S3-MINI-1_V1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
