Richmond-Baah/cnc-wireless-transfer/hardware/filexfer-pcb/3dmodels/microSD_SHOUHAN_TF_PUSH.step

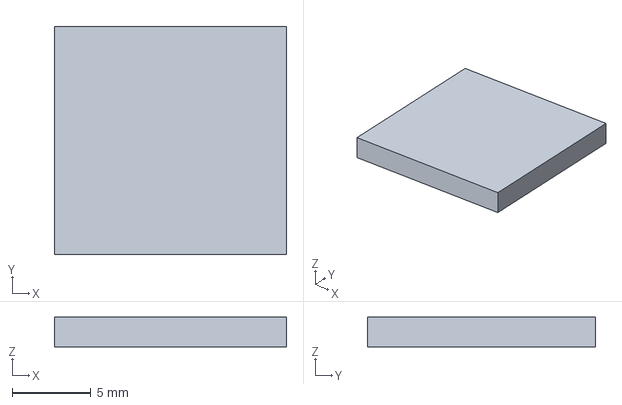
[picture p23: CAD file, 2026-11-10]
hardware/filexfer-pcb/3dmodels/microSD_SHOUHAN_TF_PUSH.step
14.8 x 14.5 x 1.90 mm
