Richmond-Baah/cnc-wireless-transfer/hardware/filexfer-pcb/3dmodels/USB_A_Plug_XKB_U217-041N-4BV81.step

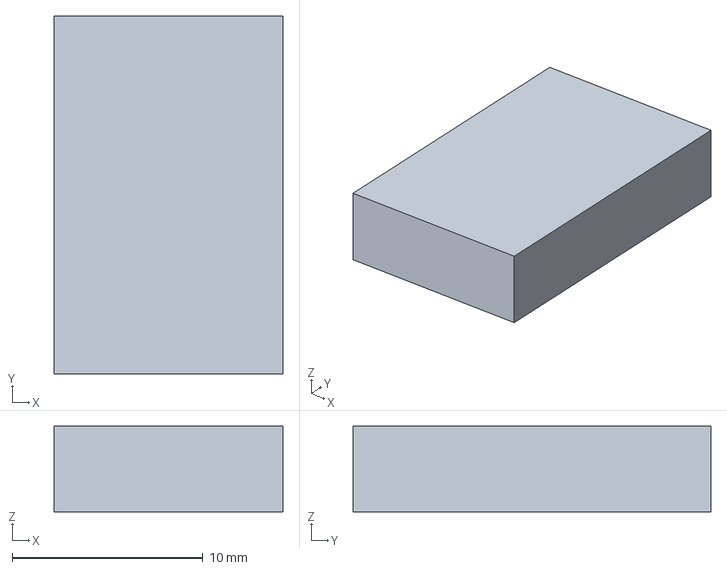
[picture p24: CAD file, 2026-11-10]
hardware/filexfer-pcb/3dmodels/USB_A_Plug_XKB_U217-041N-4BV81.step
12.0 x 18.8 x 4.50 mm
