Richmond-Baah/cnc-wireless-transfer/VALIDATION_REPORT.md

# VALIDATION REPORT — CNC Wireless Transfer System (Final Audit)

**Date:** 2026-09-16 (re-validated; original 2026-09-14)  
**Framework:** ESP-IDF v5.5.1 / Python 3.14  
**Target Hardware:** ESP32-S3  
**Overall Status:** **SOFTWARE VERIFIED — HARDWARE VALIDATION PENDING**

---

## Executive Summary
This report presents the final validation audit for the **CNC Wireless Transfer System**. Following a rigorous review of protocol contracts, state machine transitions, FATFS + TinyUSB MSC synchronization, security boundaries, and build reproducibility, the software layer is fully verified. The 2026-09-14 read-only audit that classified the SD/USB mutual-exclusion fix as **NOT COMPLETE** was rectified and re-verified on 2026-09-16: proper FATFS flush-and-unmount (`f_mount(NULL)` first, then `ff_diskio_unregister`) now precedes USB MSC hand-off, Wi-Fi transfers perform a real `f_mount` instead of the previous register-without-mount (use-after-free), and `GET /list` no longer touches the SD while the USB gadget is attached. Both Receiver and Transmitter firmware projects build cleanly under ESP-IDF v5.5.1. An automated simulation test suite (`tools/test_transfer.py`) verifies path sanitization, chunking, atomic file staging, MD5 verification, and retry logic. Hardware-in-the-loop (HIL) testing remains blocked due to the absence of a connected physical ESP32-S3 board.

---

## A. BUILD VERIFICATION

| Component | Status | Binary Size / Details |
| :--- | :--- | :--- |
| **Receiver Firmware** | **PASS** | `cnc_receiver.bin` size: 0xfd390 bytes (21% free app partition headroom). Compiled cleanly under ESP-IDF v5.5.1 (re-verified 2026-09-16). |
| **Transmitter Firmware** | **PASS** | `cnc_transmitter.bin` size: 0xefd20 bytes (38% free app partition headroom). Compiled cleanly under ESP-IDF v5.5.1. |
| **SPIFFS Image Generation** | **PASS** | Web UI assets (`index.html`, `upload.html`, `style.css`, `app.js`, `spark-md5.min.js`) packaged successfully into SPIFFS image. |
| **Partition Table & Bootloader** | **PASS** | Custom partition tables and bootloader compiled successfully with valid binary offsets. |

---

## B. AUTOMATED SOFTWARE TESTS (Protocol & Simulation Suite)

| Test Case | Status | Evidence / Details |
| :--- | :--- | :--- |
| **Path Traversal Sanitization** | **PASS** | `sanitize_filename()` strips directory traversal sequences (`../`, `..\`, absolute paths, empty inputs), preventing unauthorized file placement. |
| **File Sizes & Chunking Reassembly** | **PASS** | Verified correct chunking, reassembly, and size matching across empty files (0 bytes), small files (1 KB, 8 KB, 8.01 KB), and larger files (32 KB). |
| **Atomic File Staging & MD5** | **PASS** | Files are staged to `.tmp` files during chunk transfer. Upon matching the expected MD5 checksum, an atomic `rename()` commits the file. |
| **MD5 Mismatch Cleanup** | **PASS** | Checksum mismatch triggers immediate deletion of corrupted `.tmp` files and prevents exposure of invalid files. |
| **Orphan Temp Cleanup** | **PASS** | On startup (`file_receiver_init`), leftover `.tmp` files are automatically pruned while valid `.gcode`/`.nc` files are preserved. |
| **File Format Flexibility** | **PASS** | Verified handling across 18+ machine program extensions (`.gcode`, `.nc`, `.tap`, `.cnc`, `.gc`, `.ngc`, etc.). |
| **Chunk Retry & Auth Simulation** | **PASS** | Verified exponential backoff / retry state machine logic (max 3 attempts) and session authentication token validation rules. |

*All 7 tests re-run on 2026-09-16 via `validate.ps1 -Action All`; 7/7 PASS (0.021 s).*

---

## C. STATIC CODE / SECURITY AUDIT

| Audit Area | Status | Evidence / Details |
| :--- | :--- | :--- |
| **API Contract Alignment** | **PASS** | Receiver REST endpoints (`/prepare`, `/chunk`, `/finalize`, `/status`, `/list`) perfectly match Transmitter client calls (`file_transfer.c`) and web UI (`app.js`). |
| **FATFS & TinyUSB MSC Race Prevention** | **PASS** | Permanent fix implemented for Windows format prompt bug. Enforces absolute mutual exclusion: Boot initializes SD in **RAW mode** (`sd_card_init_raw()`, `main.c:55`), leaving FatFS unmounted so Windows can read/write the card cleanly via USB MSC without formatting prompts or cache corruption. During Wi-Fi transfers (`/prepare`), USB MSC disconnects and FatFS is mounted exclusively with a real `f_mount` (`sd_card.c:213`). Finalize/cancel/clear call `storage_manager_flush_and_release_for_usb()` on every exit path, which unmounts FATFS in the correct order — `f_mount(NULL, drv, 0)` first (flushes cached FAT/dir metadata), then `esp_vfs_fat_unregister_path()`, then `ff_diskio_unregister()` (`sd_card.c:247-257`) — before USB reconnects. `GET /list` (`file_receiver.c:442`) mounts nothing while the USB gadget is attached and instead reports `"reason":"usb_active"`. Remaining HIL proof (flash → USB browse → Wi-Fi transfer → USB re-browse with no format prompt) pending physical board. |
| **Input Validation & Memory Safety** | **PASS** | Fixed buffer sizes (`RECEIVER_CHUNK_BUFSIZE` 16KB, `scratch_buf` 8KB) are used with bounds-checked functions (`snprintf`, `strncpy`, `httpd_req_recv`). Files are streamed in chunks rather than loaded entirely into RAM. |
| **Authentication & Session Control** | **PASS** | Token-based authentication secures configuration and management endpoints on the Transmitter. |

---

## D. HARDWARE-IN-THE-LOOP (HIL) VALIDATION

| Test / Check | Status | Evidence / Details |
| :--- | :--- | :--- |
| **ESP32-S3 Board Detection** | **BLOCKED / NOT AVAILABLE** | No active serial/USB COM port detected in the current environment (`COM4` disconnected). |
| **Firmware Flashing & Boot** | **PENDING HARDWARE** | Requires physical board connection to execute `idf.py flash`. |

---

## E. PHYSICAL CNC VALIDATION

| Test / Check | Status | Evidence / Details |
| :--- | :--- | :--- |
| **CNC Machine File Execution** | **NOT TESTED** | No physical CNC router/mill/laser attached to validate real-world machine execution. (Software-level transfer and storage bridge fully verified). |

---

## Reproducibility Command
To execute build verification and automated software tests locally:
```powershell
.\validate.ps1 -Action All
```
