Richmond-Baah/cnc-wireless-transfer/hardware/filexfer-pcb/docs/img/schematic-revB.pdf

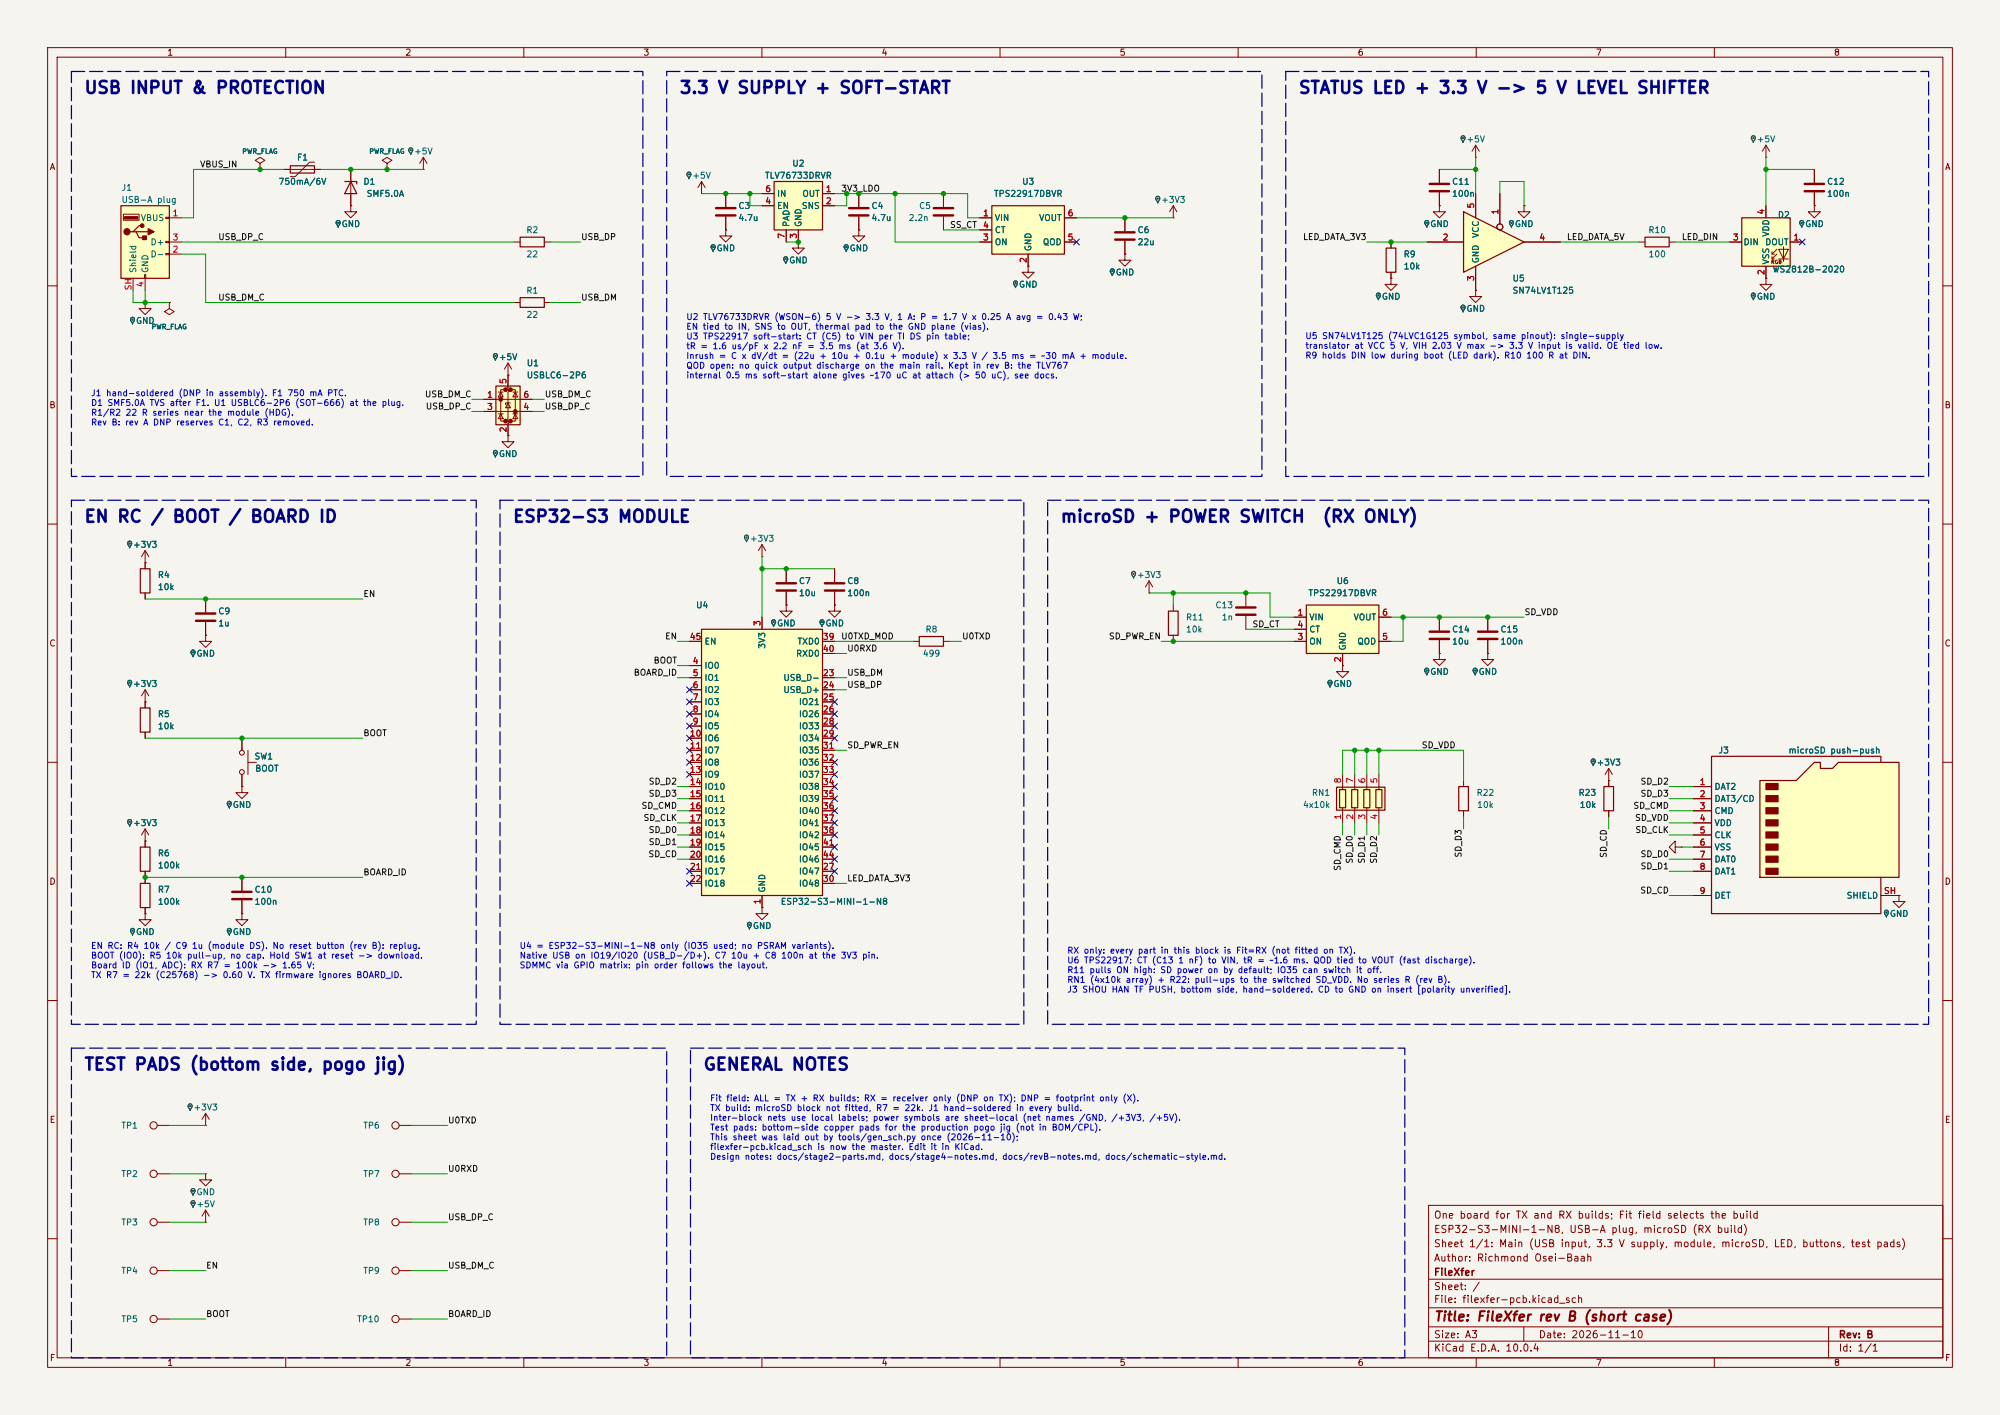
[picture p25: page 1]

translator at VCC 5 V, VIH 2.03 V max -> 3.3 V input is valid. OE tied low. R9 holds DIN low during boot (LED dark). R10 100 R at DIN. USB INPUT & PROTECTION

U2 TLV76733DRVR (WSON-6) 5 V -> 3.3 V, 1 A: P = 1.7 V x 0.25 A avg = 0.43 W; EN tied to IN, SNS to OUT, thermal pad to the GND plane (vias). U3 TPS22917 soft-start: CT (C5) to VIN per TI DS pin table; tR = 1.6 us/pF x 2.2 nF = 3.5 ms (at 3.6 V).

U5 SN74LV1T125 (74LVC1G125 symbol, same pinout): single-supply

Inrush = C x dV/dt = (22u + 10u + 0.1u + module) x 3.3 V / 3.5 ms = ~30 mA + module. QOD open: no quick output discharge on the main rail. Kept in rev B: the TLV767

internal 0.5 ms soft-start alone gives ~170 uC at attach (> 50 uC), see docs. TEST PADS (bottom side, pogo jig)

J1 hand-soldered (DNP in assembly). F1 750 mA PTC. D1 SMF5.0A TVS after F1. U1 USBLC6-2P6 (SOT-666) at the plug.

U4 = ESP32-S3-MINI-1-N8 only (IO35 used; no PSRAM variants). Native USB on IO19/IO20 (USB_D-/D+). C7 10u + C8 100n at the 3V3 pin. SDMMC via GPIO matrix: pin order follows the layout.

Fit field: ALL = TX + RX builds; RX = receiver only (DNP on TX); DNP = footprint only (X). TX build: microSD block not fitted, R7 = 22k. J1 hand-soldered in every build.

Inter-block nets use local labels; power symbols are sheet-local (net names /GND, /+3V3, /+5V). Test pads: bottom-side copper pads for the production pogo jig (not in BOM/CPL). This sheet was laid out by tools/gen_sch.py once (2026-11-10);

filexfer-pcb.kicad_sch is now the master. Edit it in KiCad. Design notes: docs/stage2-parts.md, docs/stage4-notes.md, docs/revB-notes.md, docs/schematic-style.md.

TP9 GND
One board for TX and RX builds; Fit field selects the build +5V

ESP32-S3-MINI-1-N8, USB-A plug, microSD (RX build)
Sheet 1/1: Main (USB input, 3.3 V supply, module, microSD, LED, buttons, test pads)
Author: Richmond Osei-Baah
FileXfer
Sheet: /
File: filexfer-pcb.kicad_sch
Title: FileXfer rev B (short case)

Size: A3 | Rev: B
KiCad E.D.A. 10.0.4 | Id: 1/1 | F Date: 2026-11-10
