Richmond-Baah/cnc-wireless-transfer/hardware/filexfer-pcb/filexfer-pcb.kicad_pcb

## KiCad design hardware/filexfer-pcb/filexfer-pcb.kicad_pcb (2026-11-10)

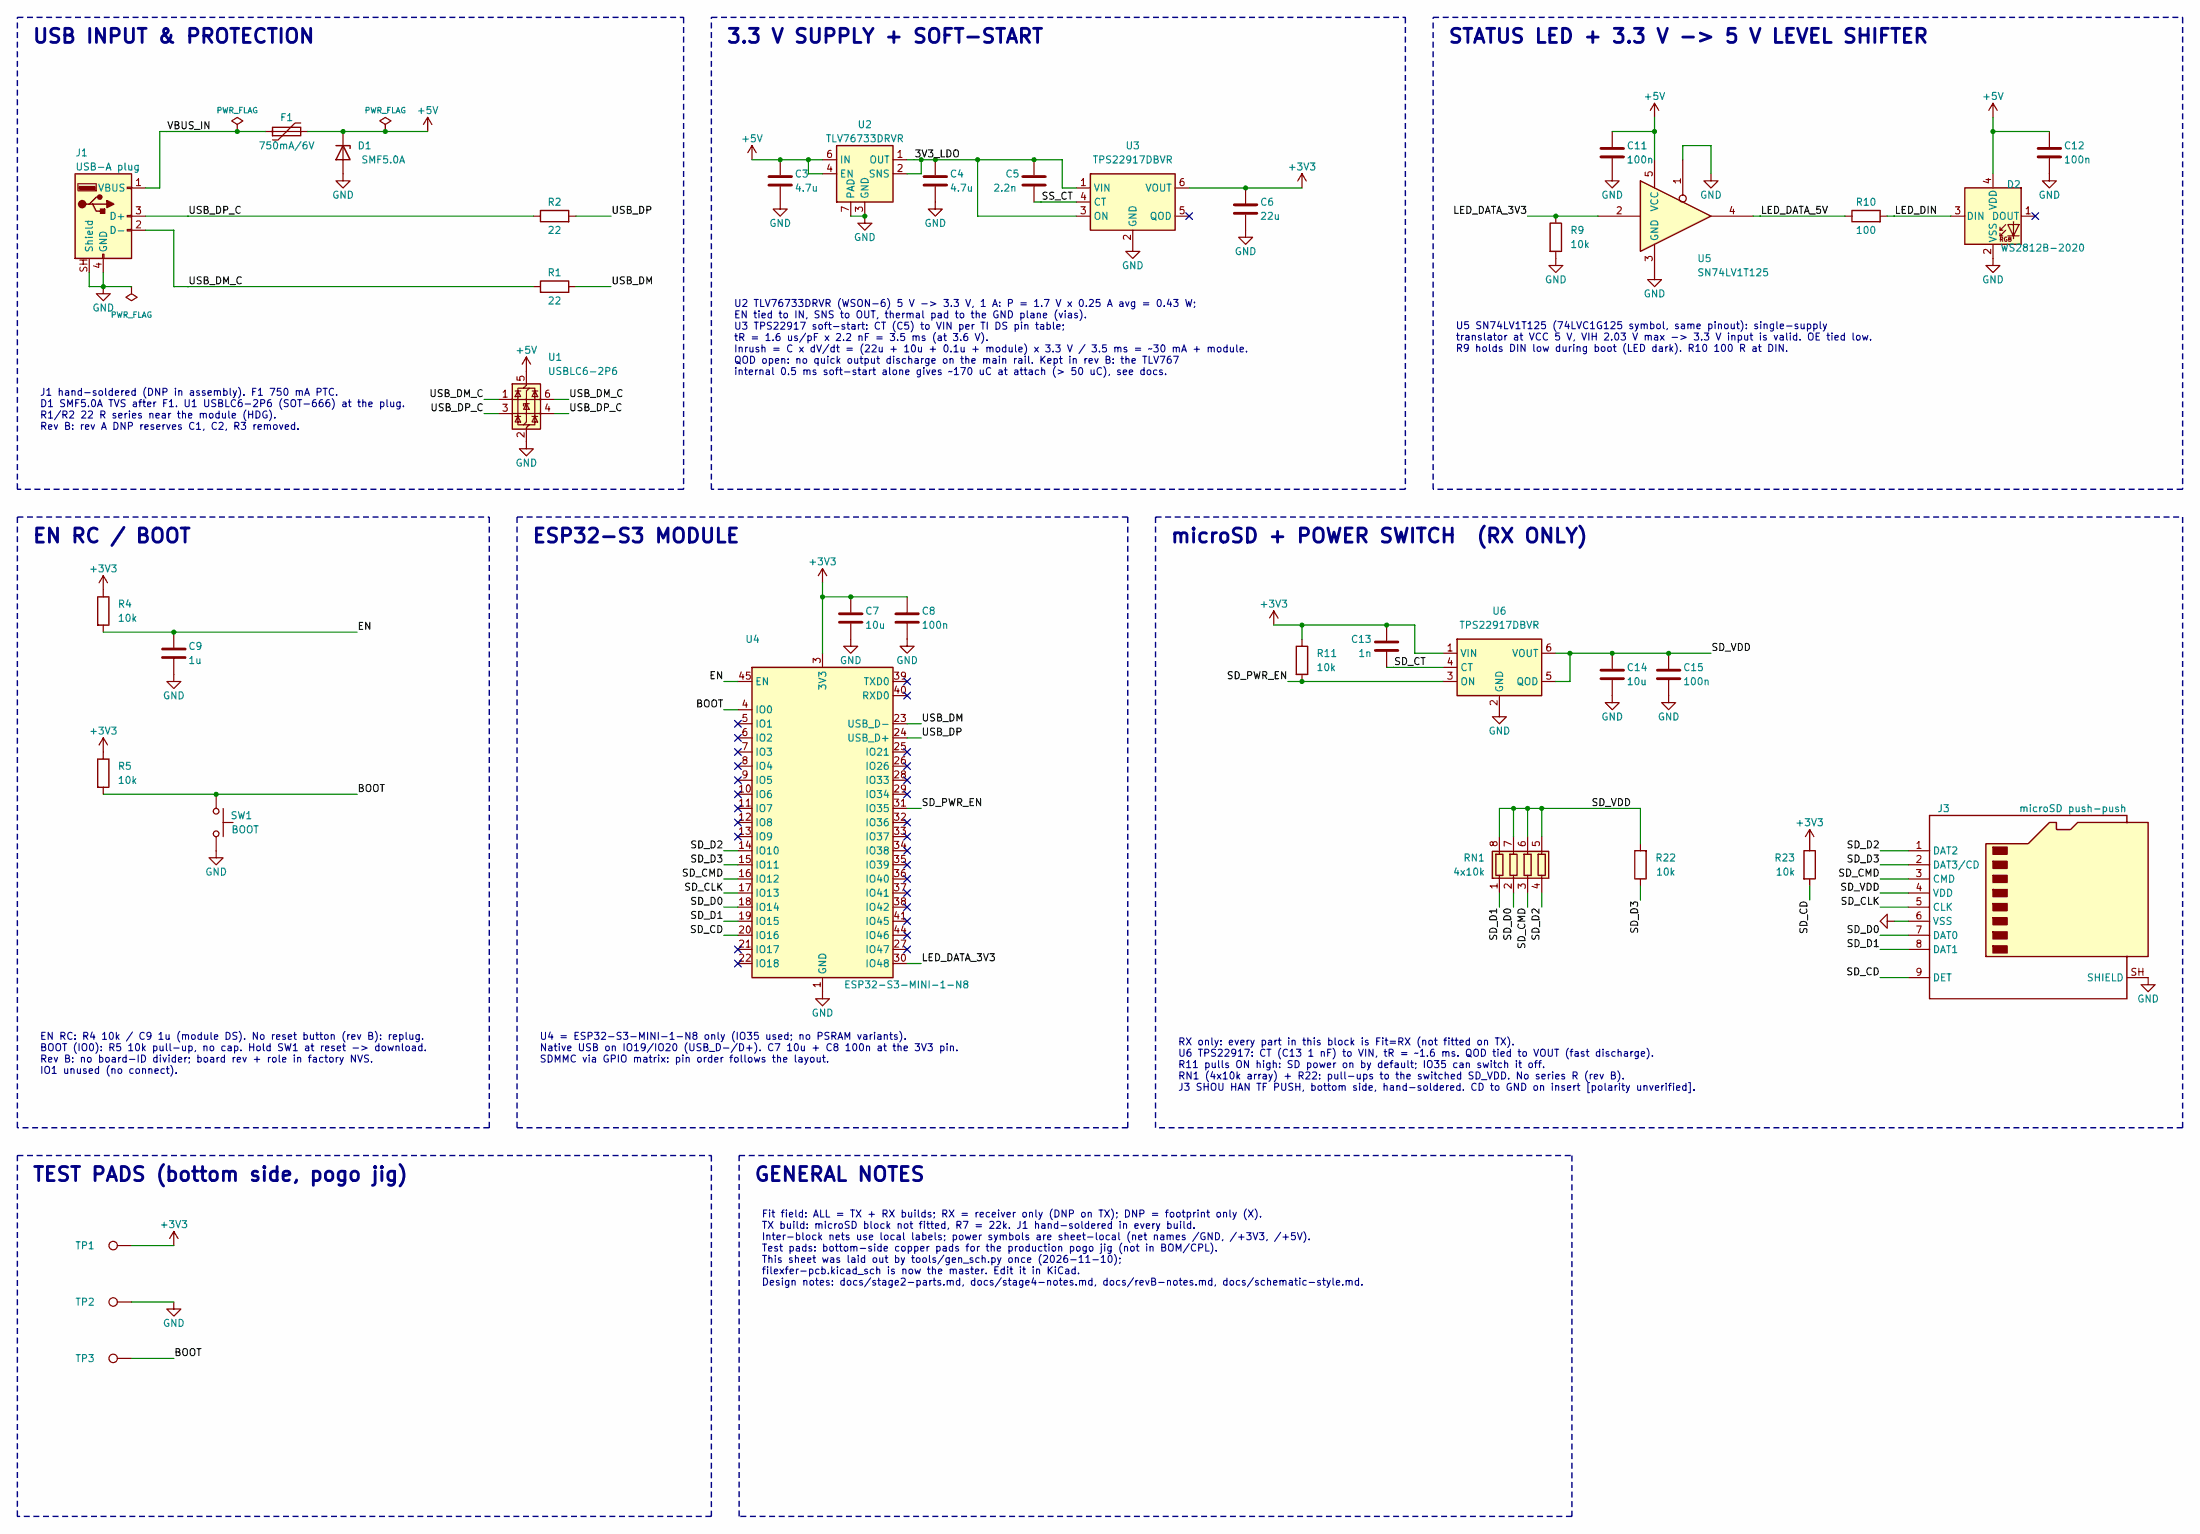
[picture p26: schematic filexfer-pcb.kicad_sch, FileXfer rev B (short case)]

Parts:
C3, C4: 4.7u; C_0603_1608Metric; MPN CL10A475KO8NNNC; LCSC C19666
C5: 2.2n; C_0402_1005Metric; MPN 0402B222K500NT; LCSC C1531
C6: 22u; C_0603_1608Metric; MPN CL10A226MQ8NRNC; LCSC C59461
C7, C14: 10u; C_0402_1005Metric; MPN CL05A106MQ5NUNC; LCSC C15525
C8, C11, C12, C15: 100n; C_0402_1005Metric; MPN CL05B104KO5NNNC; LCSC C1525
C9: 1u; C_0402_1005Metric; MPN CL05A105KA5NQNC; LCSC C52923
C13: 1n; C_0402_1005Metric; MPN 0402B102K500NT; LCSC C1523
D1: SMF5.0A; D_SMF; MPN SMF5.0A (Leiditech); LCSC C2759874
D2: WS2812B-2020; LED_WS2812B-2020_PLCC4_2.0x2.0mm; MPN WS2812B-2020-V6; LCSC C52917434
F1: 750mA/6V; Fuse_1206_3216Metric; MPN BSMD1206-075-6V; LCSC C883127
J1: USB-A plug; USB_A_Plug_XKB_U217-041N-4BV81; MPN U217-041N-4BV81; LCSC C319178
J3: microSD push-push; microSD_SHOUHAN_TF_PUSH; MPN TF PUSH (SHOU HAN); LCSC C393941
R1, R2: 22; R_0402_1005Metric; MPN 0402WGF220JTCE; LCSC C25092
R4, R5, R9, R11, R22, R23: 10k; R_0402_1005Metric; MPN 0402WGF1002TCE; LCSC C25744
R10: 100; R_0402_1005Metric; MPN 0402WGF1000TCE; LCSC C25076
RN1: 4x10k; R_Array_Convex_4x0402; MPN 4D02WGJ0103TCE; LCSC C25725
SW1: BOOT; SW_SPST_TS-1088-xR020; MPN TS-1088-AR02016; LCSC C720477
TP1: +3V3; TestPoint_Pad_D1.0mm; MPN pad
TP2: GND; TestPoint_Pad_D1.0mm; MPN pad
TP3: BOOT; TestPoint_Pad_D1.0mm; MPN pad
U1: USBLC6-2P6; SOT-666; MPN USBLC6-2P6; LCSC C15999
U2: TLV76733DRVR; WSON-6-1EP_2x2mm_P0.65mm_EP1x1.6mm; MPN TLV76733DRVR; LCSC C2848334
U3, U6: TPS22917DBVR; SOT-23-6; MPN TPS22917DBVR; LCSC C2681320
U4: ESP32-S3-MINI-1-N8; ESP32-S3-MINI-1; MPN ESP32-S3-MINI-1-N8; LCSC C2913206
U5: SN74LV1T125; SOT-353_SC-70-5; MPN SN74LV1T125DCKR; LCSC C75925

Connections:
/3V3_LDO: C4.1, C5.2, U2.1 (OUT), U2.2 (SNS), U3.1 (VIN), U3.3 (ON)
/+3V3: C6.1, C7.1, C8.1, C13.2, R4.1, R5.1, R11.1, R23.1, TP1.1, U3.6 (VOUT), U4.3 (3V3), U6.1 (VIN)
/+5V: C3.1, C11.1, C12.1, D1.1 (K), D2.4 (VDD), F1.2, U1.5 (VBUS), U2.4 (EN), U2.6 (IN), U5.5 (VCC)
/BOOT: R5.2, SW1.1, TP3.1, U4.4 (IO0)
/EN: C9.1, R4.2, U4.45 (EN)
/GND: C3.2, C4.2, C6.2, C7.2, C8.2, C9.2, C11.2, C12.2, C14.2, C15.2, D1.2 (A), D2.2 (VSS), J1.4 (GND), J1.SH (Shield), J3.6 (VSS), J3.SH (SHIELD), R9.2, SW1.2, TP2.1, U1.2 (GND), U2.3 (GND), U2.5 (GND), U2.7 (PAD), U3.2 (GND), U4.1 (GND), U4.2 (GND), U4.42 (GND), U4.43 (GND), U4.46 (GND), U4.47 (GND), U4.48 (GND), U4.49 (GND), U4.50 (GND), U4.51 (GND), U4.52 (GND), U4.53 (GND), U4.54 (GND), U4.55 (GND), U4.56 (GND), U4.57 (GND), U4.58 (GND), U4.59 (GND), U4.60 (GND), U4.61 (GND), U4.62 (GND), U4.63 (GND), U4.64 (GND), U4.65 (GND), U5.1, U5.3 (GND), U6.2 (GND)
/LED_DATA_3V3: R9.1, U4.30 (IO48), U5.2
/LED_DATA_5V: R10.1, U5.4
/LED_DIN: D2.3 (DIN), R10.2
/SD_CD: J3.9 (DET), R23.2, U4.20 (IO16)
/SD_CLK: J3.5 (CLK), U4.17 (IO13)
/SD_CMD: J3.3 (CMD), RN1.3 (R3.1), U4.16 (IO12)
/SD_CT: C13.1, U6.4 (CT)
/SD_D0: J3.7 (DAT0), RN1.2 (R2.1), U4.18 (IO14)
/SD_D1: J3.8 (DAT1), RN1.1 (R1.1), U4.19 (IO15)
/SD_D2: J3.1 (DAT2), RN1.4 (R4.1), U4.14 (IO10)
/SD_D3: J3.2 (DAT3/CD), R22.1, U4.15 (IO11)
/SD_PWR_EN: R11.2, U4.31 (IO35), U6.3 (ON)
/SD_VDD: C14.1, C15.1, J3.4 (VDD), R22.2, RN1.5 (R4.2), RN1.6 (R3.2), RN1.7 (R2.2), RN1.8 (R1.2), U6.5 (QOD), U6.6 (VOUT)
/SS_CT: C5.1, U3.4 (CT)
/USB_DM: R1.2, U4.23 (USB_D-)
/USB_DM_C: J1.2 (D-), R1.1, U1.1 (I/O1), U1.6 (I/O1)
/USB_DP: R2.2, U4.24 (USB_D+)
/USB_DP_C: J1.3 (D+), R2.1, U1.3 (I/O2), U1.4 (I/O2)
/VBUS_IN: F1.1, J1.1 (VBUS)

Notes on the sheet:
USB INPUT & PROTECTION
3.3 V SUPPLY + SOFT-START
STATUS LED + 3.3 V -> 5 V LEVEL SHIFTER
EN RC / BOOT
ESP32-S3 MODULE
microSD + POWER SWITCH (RX ONLY)
TEST PADS (bottom side, pogo jig)
GENERAL NOTES
J1 hand-soldered (DNP in assembly). F1 750 mA PTC. D1 SMF5.0A TVS after F1. U1 USBLC6-2P6 (SOT-666) at the plug. R1/R2 22 R series near the module (HDG). Rev B: rev A DNP reserves C1, C2, R3 removed.
U2 TLV76733DRVR (WSON-6) 5 V -> 3.3 V, 1 A: P = 1.7 V x 0.25 A avg = 0.43 W; EN tied to IN, SNS to OUT, thermal pad to the GND plane (vias). U3 TPS22917 soft-start: CT (C5) to VIN per TI DS pin table; tR = 1.6 us/pF x 2.2 nF = 3.5 ms (at 3.6 V). Inrush = C x dV/dt = (22u + 10u + 0.1u + module) x 3.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
U5 SN74LV1T125 (74LVC1G125 symbol, same pinout): single-supply translator at VCC 5 V, VIH 2.03 V max -> 3.3 V input is valid. OE tied low. R9 holds DIN low during boot (LED dark). R10 100 R at DIN.
EN RC: R4 10k / C9 1u (module DS). No reset button (rev B): replug. BOOT (IO0): R5 10k pull-up, no cap. Hold SW1 at reset -> download. Rev B: no board-ID divider; board rev + role in factory NVS. IO1 unused (no connect).
U4 = ESP32-S3-MINI-1-N8 only (IO35 used; no PSRAM variants). Native USB on IO19/IO20 (USB_D-/D+). C7 10u + C8 100n at the 3V3 pin. SDMMC via GPIO matrix: pin order follows the layout.
RX only: every part in this block is Fit=RX (not fitted on TX). U6 TPS22917: CT (C13 1 nF) to VIN, tR = ~1.6 ms. QOD tied to VOUT (fast discharge). R11 pulls ON high: SD power on by default; IO35 can switch it off. RN1 (4x10k array) + R22: pull-ups to the switched SD_VDD. No series R (rev B). J3 SH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
Fit field: ALL = TX + RX builds; RX = receiver only (DNP on TX); DNP = footprint only (X). TX build: microSD block not fitted, R7 = 22k. J1 hand-soldered in every build. Inter-block nets use local labels; power symbols are sheet-local (net names /GND, /+3V3, /+5V). Test pads: bottom-side copper pad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

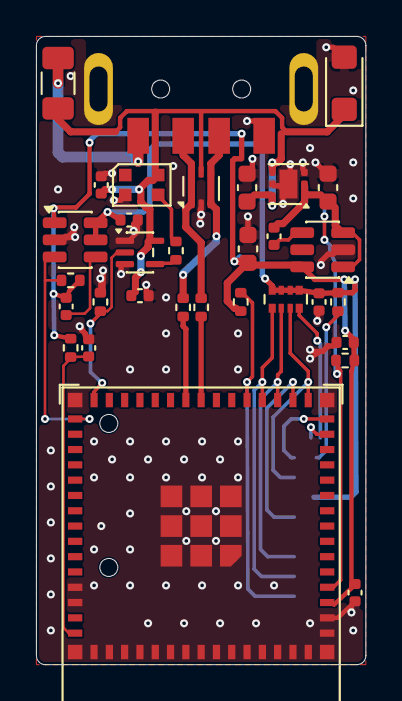
[picture p27: board filexfer-pcb.kicad_pcb from above]

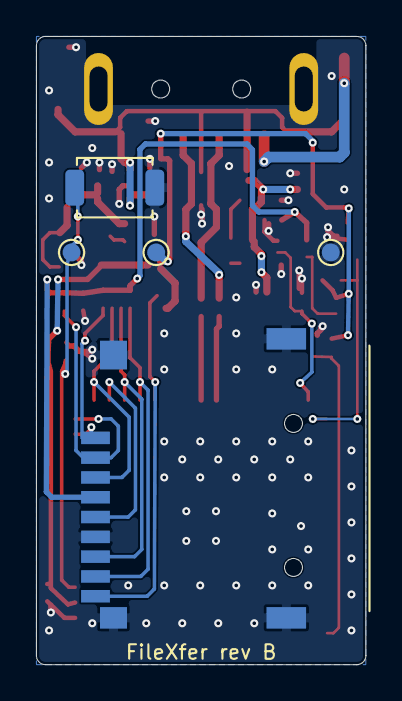
[picture p28: board filexfer-pcb.kicad_pcb from below]

Board: 2 copper layers, 18.3 x 34.9 mm, 37 parts (5 on the bottom side), 25 nets.
