Richmond-Baah/cnc-wireless-transfer/hardware/filexfer-pcb/firmware/board_config.h

/*
 * board_config.h — PROPOSAL (Stage 3), not yet used by receiver/ or transmitter/.
 *
 * Pins per board revision for FileXfer. Intended home: components/board_config/include/.
 * Selection: CONFIG_FILEXFER_BOARD_* (Kconfig) picks the pin set at build time;
 * Rev A: board_id_read() checks at boot that the hardware matches (role + rev) and logs/refuses on mismatch.
 * Rev B: no board-ID divider (removed for routing room, 2026-11-10). Board rev + role are written to a
 *        factory NVS partition at production test (see stage2-parts.md firmware backlog 4).
 *
 * Sources: hardware/filexfer-pcb/filexfer-pcb.kicad_sch (rev A, generated by tools/gen_sch.py),
 *          current firmware: receiver/main/sd_card.c:23-26, receiver/main/led.c:9,
 *          transmitter/main/led.c:8, components/boot_button/boot_button.c:6.
 */
#pragma once

/* ---- Common to all boards -------------------------------------------------------------- */
#define BOARD_PIN_BOOT          0    /* BOOT pinhole, active low (10k pull-up on rev A)        */
#define BOARD_PIN_USB_DM        19
#define BOARD_PIN_USB_DP        20
#define BOARD_PIN_U0TXD         43   /* console; rev A: 499R series, test pad TP6                */
#define BOARD_PIN_U0RXD         44   /* test pad TP7                                             */
#define BOARD_PIN_LED           48   /* WS2812-protocol, 1 LED                                  */

#if defined(CONFIG_FILEXFER_BOARD_SUPERMINI)
/* ---- Legacy: ESP32-S3 Super Mini + SPI microSD module ---------------------------------------- */
#define BOARD_NAME              "supermini"
#define BOARD_SD_MODE_SPI       1
#define BOARD_PIN_SD_CLK        12
#define BOARD_PIN_SD_MOSI       11
#define BOARD_PIN_SD_MISO       13
#define BOARD_PIN_SD_CS         10
#define BOARD_PIN_SD_PWR        (-1)
#define BOARD_PIN_SD_CD         (-1)
#define BOARD_PIN_BOARD_ID      (-1) /* no ID resistor: role from build only                    */
#define BOARD_LED_5V_BUFFERED   0    /* LED powered by the Super Mini, driven directly at 3.3 V */

#elif defined(CONFIG_FILEXFER_BOARD_FX_REV_A)
/* ---- FileXfer PCB rev A (ESP32-S3-MINI-1-N8) --------------------------------------------- */
#define BOARD_NAME              "fx-a"
#define BOARD_SD_MODE_SPI       0    /* SDMMC 4-bit; set 1 to run SPI on the same pins:          */
#define BOARD_PIN_SD_CLK        13   /*   CLK  = SPI CLK                                        */
#define BOARD_PIN_SD_CMD        12   /*   CMD  = SPI MOSI                                       */
#define BOARD_PIN_SD_D0         14   /*   D0   = SPI MISO                                       */
#define BOARD_PIN_SD_D1         15   /* SDMMC via GPIO matrix; pins in module-edge order (routing) */
#define BOARD_PIN_SD_D2         10
#define BOARD_PIN_SD_D3         11   /*   D3   = SPI CS                                         */
#define BOARD_PIN_SD_MOSI       BOARD_PIN_SD_CMD
#define BOARD_PIN_SD_MISO       BOARD_PIN_SD_D0
#define BOARD_PIN_SD_CS         BOARD_PIN_SD_D3
#define BOARD_PIN_SD_PWR        35   /* IO35 = module pin 31 (schematic SD_PWR_EN), TPS22917 ON, 10k pull-up: card ON by default.
                                      * Power-cycle: set SD pins input/low first (no back-power),
                                      * drive low >= 50 ms (QOD discharge), release, wait >= 5 ms. */
#define BOARD_SD_PWR_ACTIVE     1
#define BOARD_PIN_SD_CD         16   /* Cd switch to shell/GND, 10k pull-up; sense TBD on bench */
#define BOARD_PIN_BOARD_ID      1    /* ADC1_CH0, 100k top / R7 bottom, 100 nF                  */
#define BOARD_LED_5V_BUFFERED   1    /* LED on VBUS via SN74LV1T125; 10k pull-down on GPIO48   */

#elif defined(CONFIG_FILEXFER_BOARD_FX_REV_B)
/* ---- FileXfer PCB rev B (short case): same module pins as rev A --------------------------- */
#define BOARD_NAME              "fx-b"
#define BOARD_SD_MODE_SPI       0
#define BOARD_PIN_SD_CLK        13
#define BOARD_PIN_SD_CMD        12
#define BOARD_PIN_SD_D0         14
#define BOARD_PIN_SD_D1         15
#define BOARD_PIN_SD_D2         10
#define BOARD_PIN_SD_D3         11
#define BOARD_PIN_SD_MOSI       BOARD_PIN_SD_CMD
#define BOARD_PIN_SD_MISO       BOARD_PIN_SD_D0
#define BOARD_PIN_SD_CS         BOARD_PIN_SD_D3
#define BOARD_PIN_SD_PWR        35   /* IO35 = module pin 31 (schematic SD_PWR_EN); TPS22917 ON, 10k pull-up */
#define BOARD_SD_PWR_ACTIVE     1
#define BOARD_PIN_SD_CD         16
#define BOARD_PIN_BOARD_ID      (-1) /* IO1 not connected; rev + role from factory NVS              */
#define BOARD_LED_5V_BUFFERED   1
/* SD lines run ~7-15 mm on the bottom layer without a GND plane directly under them (2-layer rev B).
 * Start SDMMC at high speed (40 MHz); on CRC / timeout errors at init or transfer, retry at 20 MHz
 * (SDMMC_FREQ_DEFAULT) and stay there until reboot. Bench-verify both rates.                         */
#define BOARD_SD_FREQ_FALLBACK_KHZ 20000

#else
#error "Select a board: CONFIG_FILEXFER_BOARD_SUPERMINI, _FX_REV_A or _FX_REV_B"
#endif

/* ---- Board ID (rev A only): V = 3.3 * R7 / (100k + R7), read with ADC1 12 dB attenuation ---- */
/* Windows are +-150 mV around nominal; anything else = unknown -> log, fall back to build role.    */
typedef enum { BOARD_ROLE_UNKNOWN = 0, BOARD_ROLE_TX, BOARD_ROLE_RX } board_role_t;

typedef struct {
    int          mv;      /* nominal mV at GPIO1 */
    board_role_t role;
    char         rev;     /* 'A', 'B', ... */
} board_id_code_t;

#define BOARD_ID_WINDOW_MV 150
#define BOARD_ID_CODES {                                   \
    {  595, BOARD_ROLE_TX, 'A' },  /* R7 = 22k  */         \
    { 1650, BOARD_ROLE_RX, 'A' },  /* R7 = 100k */         \
    /* rev B has no divider (BOARD_PIN_BOARD_ID = -1): use factory NVS */ \
}
