Richmond-Baah/cnc-wireless-transfer/(commit log)

2026-09-13 Initial commit: CNC Wireless Transfer (Transmitter & Receiver)
2026-10-17 Fix receiver SD/USB hand-off and transfer error recovery
    Includes the previously uncommitted SD/USB mutual-exclusion rework
    (raw SD at boot, real f_mount, flush-first unmount) plus:
    - sd_card_ensure_fatfs: never auto-format on mount failure; log and
    enter ERROR (ERROR now reachable from any state).
    - Receiver error paths (prepare/chunk/finalize-read) delete the .tmp,
    release FatFS and reconnect USB; transmitter calls /cancel on chunk
    or client read failure.
    - /chunk honours X-Chunk-Index: duplicates acked and dropped,
    out-of-order rejected with 409; index reset on /prepare.
    - /list releases storage it mounted for listing.
2026-10-17 Add CARD_ERROR state for unreadable SD card
    - Boot mount failure sets STATE_CARD_ERROR (slow, persistent red blink)
    instead of the generic ERROR; reported in /status (state + card_error).
    - CARD_ERROR -> USB_ACTIVE allowed so the host can reformat the card;
    host eject/unmount and the next /prepare retry the mount and return
    to IDLE on success.
    - Transmitter UI shows a format hint for CARD_ERROR; /status buffer
    raised to 256 bytes to fit the longer receiver JSON.
    - .gitignore: __pycache__/
2026-10-17 Add guarded card Format to transmitter UI; reject over-long inputs
    - Transmitter: /receiver_format proxy (auth + {"confirm":"FORMAT"}),
    UI button shown only on CARD_ERROR, requires typing FORMAT; receiver
    /format timeout raised to 120 s. Receiver clears CARD_ERROR after a
    successful format.
    - Length checks instead of silent truncation: transmitter /config
    fields, receiver /settings (full-body read, size limit, SSID/pass
    length), receiver /prepare filename/md5.
2026-10-17 Add machine-busy guard to /prepare; release storage after /format
    - Receiver records the last USB READ10; /prepare returns 423
    {"error":"machine_busy"} if the host read within 10 s, unless
    X-Force: 1. Transmitter forwards X-Force and relays the 423; UI shows
    the warning with a "send anyway" button that resends with X-Force.
    - /format releases storage to raw USB mode before reconnecting (flash
    format previously left FatFS mounted, so USB reported not-ready).
    - UI shows "Formatting - don't unplug" while waiting.
2026-10-17 Validate /prepare filenames; relay receiver errors; log USB host reads
    - Receiver /prepare rejects names with / \ : .. or control chars, or
    empty/dots-only, with 400. Transmitter reads the receiver's error body
    and relays 400 to the UI, which shows the reason.
    - usb_msc: once-per-second UART log of host READ10 activity (count,
    bytes, min/max LBA) behind CONFIG_CNC_USB_READ_LOG (default y).
2026-10-17 UI polish: cached file list, storage refresh, UTF-8, layout, WIPE guard
    Receiver:
    - Cache file list + total/free space in RAM at boot (before USB),
    after finalize, wipe and format; /list serves it with "cached":true
    while the USB host owns the drive; /status reports cached sizes then.
    - /clear requires {"confirm":"WIPE"} and honours the machine-busy guard.
    - /status reports firmware version ("fw"); PROJECT_VER 1.1.0.
    - charset=utf-8 on html/json responses; meta charset on its page.
    Transmitter:
    - /receiver_clear checks WIPE server-side, forwards X-Force, relays 423.
    - /status adds "tx_fw"; status cache/list buffers enlarged.
    - charset=utf-8 on html/css/js/json; app.js repaired from doub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
2026-10-17 Transmitter: robust receiver status poll and /list proxy with logged reasons
    - Status poll: 3 s timeout (was 1.2 s; receiver's single-threaded httpd
    can be busy with /list or /finalize), full body read, JSON sanity
    check, OFFLINE only after 3 consecutive failures; each failure logged
    with reason (connect error, HTTP code, timeout, size, body) and elapsed
    time.
    - /list proxy: 15 s timeout, logs connect/HTTP/timeout failures and
    rejects truncated or non-JSON bodies instead of passing them on.
    - Receiver URL log demoted to debug (was logged every 2 s).
2026-10-17 Transfer speed: 32 KB full chunks, stage timing logs on both boards
    - Transmitter: chunk size 8 -> 32 KB, filled completely from the browser
    before sending (httpd_req_recv returns partial reads, so chunks were
    often ~1.4 KB = many round trips). Single keep-alive client for all
    chunks with a connection counter to verify reuse. Finalize timeout
    5 -> 30 s. Logs prepare, browser wait, chunk RTT avg/min/max, retries,
    finalize and a KB/s summary line.
    - Receiver: per-transfer timings for USB release, mount, open, recv,
    write, MD5, commit, snapshot, unmount, USB reconnect and a KB/s
    summary line. Chunk buffer unchanged (16 KB) - 32 KB chunks are
    streamed through it.
    - Both: esp_time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
2026-10-18 Browser-driven chunked upload with acked progress and stages
    - New API: /upload_begin (name, size, md5 -> receiver /prepare, returns
    session), /upload_chunk (X-Session, X-Chunk-Index, <=32 KB body ->
    receiver /chunk, replies after the receiver ack), /upload_finish
    (-> receiver /finalize with the browser MD5), /upload_cancel
    (-> receiver /cancel). Auth on all; busy guard (423/X-Force) and
    filename/md5 checks kept; /prepare body built with cJSON.
    - Single session; a stale one (>60 s idle) is replaced, and a receiver
    stuck RECEIVING without a session is cancelled and retried once.
    - Old single-request /upload path and abort flag removed.
    - /finalize replies o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
2026-10-18 Transmitter: stop socket starvation that blocked spark-md5.min.js
    Chunked-upload rework keeps a receiver chunk client open for the whole
    session; with httpd at 7 (+3 reserved) of LWIP_MAX_SOCKETS=10 plus the
    status poller, accept() for page assets could fail and SparkMD5 never
    loaded. Raise LWIP_MAX_SOCKETS to 16 and enable httpd LRU purge.
2026-10-18 Transmitter: close upload session socket on chunk error and 30 s idle
    - Chunk transport error / non-200: close the keep-alive receiver socket
    (browser retry reconnects).
    - Poller task expires sessions idle > 30 s (was 60 s, and only checked on
    the next begin): closes socket, cancels receiver.
    - New /upload_begin replaces any existing session instead of 409.
    - s_up guarded by a mutex shared by httpd handlers and the reaper.
2026-10-18 Transmitter: settings prefill/merge, mDNS cnc-transfer.local, STA status
    - /config GET built JSON with unescaped snprintf and returned passwords;
    any quote/backslash broke r.json() and the error was swallowed, so the
    form stayed empty. Now cJSON, no passwords; fetch errors are shown.
    - /config POST: blank/missing = keep current for every field; after merge
    AP SSID, receiver IP and admin user must be non-empty (400 otherwise).
    Receiver sync sends merged AP values, only when they changed.
    - mDNS hostname cnc-transfer (espressif/mdns), also DHCP hostname on STA.
    - STA state/reason/IP in /status and the status card; after 5 failed
    attempts on a never-connected link, stop retrying so th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
2026-10-19 Free-space check before upload and per-file delete
    - Receiver /prepare: after mount, require size + max(64 KB, 1% of drive)
    free (same-name file still counts as used); else 507 with sizes before
    writing, snapshot, release storage, reconnect USB.
    - Receiver /delete {"files":[...]}: one mount cycle, root files only with
    the upload filename rules, folders refused, missing files skipped and
    reported; busy guard (423 unless X-Force); snapshot + USB reconnect.
    - Transmitter: 507 passes through /upload_begin; /receiver_delete proxy.
    - UI: Start blocked when the file doesn't fit ("File is X, drive has Y
    free. Delete about Z below."), same message on 507 with the file kept
    selected; check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
2026-10-20 Receiver: ID, DHCP, heartbeat, pairing key auth (multi-receiver stage A)
    - ID "rx-"+last 3 MAC bytes, default name "Receiver XXXX"; DHCP instead
    of fixed 192.168.4.150; mDNS hostname cnc-<id>.
    - Heartbeat POST <gateway>/rx/heartbeat every 10 s with id, name, ip, fw,
    state, storage type/total/free, card_error, busy, config_version (+key
    when paired). Newer config_version in the reply -> GET /rx/config and
    apply the AP credentials.
    - /pair only while unpaired (32-byte key in NVS); /unpair with key;
    hold BOOT 10 s clears pairing. Once paired every API endpoint needs
    X-Auth-Key. "/" is info only. /settings removed (replaced by pull).
    Note: the transmitter side lands in stage B; unti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
2026-10-20 Transmitter: receiver registry, pairing, per-receiver proxies (stage B)
    - rx_registry: paired list (id, name, key) in NVS, max 16; unknown or
    key-less heartbeats -> pending list in RAM; online = heartbeat < 30 s.
    - POST /rx/heartbeat, GET /rx/config (receiver key auth) for AP creds.
    - GET /receivers, POST /receivers/approve (new 32-byte key -> receiver
    /pair), /receivers/rename, /receivers/unpair (best-effort /unpair).
    - Upload/list/delete/wipe/format/status take X-Rx-Id (or ?rx=) and send
    that receiver's X-Auth-Key. One upload session globally (409 for a
    different receiver; same receiver still replaces). Status poller
    replaced by heartbeats + live /status with 2 s timeout; idle re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
2026-10-20 UI: machine selector, new-device approval, rename/unpair (stage C)
    - Machine cards (name, online/offline, state, free space, busy); the
    selection is remembered in localStorage (guarded) and locked during an
    upload. Upload, file list, delete, wipe and format send X-Rx-Id.
    - "New device found" banner with a name field + Approve.
    - Settings: per-receiver Rename and Unpair.
    - CLAUDE.md: multi-receiver architecture and pairing invariants.
2026-10-20 Multi-receiver follow-ups: cached status, recovery mode, clearer messages
    - /status and machine cards read the heartbeat cache only (no live
    receiver /status from handlers); /delete replies refresh free space.
    - Saving a new AP SSID/password lists offline paired receivers in a
    confirm dialog.
    - Recovery mode (Settings, type RECOVERY): AP on factory credentials for
    5 min, then reverts; /status reports recovery_s. Receivers already
    alternate saved/factory creds every 10 failed connects and pull the
    current creds via config_version once back on the AP.
    - 409 -> "Busy: uploading to <name>"; unpairing an offline receiver ->
    "Hold its BOOT button 10 s to finish".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
2026-10-21 Wi-Fi max TX power as Kconfig option (default 8.5 dBm), both boards
    Both boards forced 19.5 dBm (esp_wifi_set_max_tx_power(78)); at max
    power small ESP32-S3 boards can brown out and the AP may not be seen.
    CONFIG_CNC_WIFI_MAX_TX_POWER (0.25 dBm units, default 34 = 8.5 dBm) is
    applied after esp_wifi_start(); requested and actual values are logged.
2026-10-21 Transmitter: AP max_connection 15, connected-device count, approve warning
    - ap.max_connection = ESP_WIFI_MAX_CONN_NUM (15 on ESP32-S3), was 4.
    - /status reports wifi_mode, ap_clients and ap_max_clients; the status
    card shows "Wi-Fi devices: n/15".
    - In AP mode, approving a 13th+ receiver asks to confirm: "Leave room
    for phones/laptops; for more machines use router mode."
2026-10-23 Add machine: ESP-NOW pairing window with encrypted PAIR_CFG (stage A)
2026-10-23 Pairing file fallback: pair.cfg with 24 h pre-registered key (stage B)
2026-10-26 Busy guard first in /prepare, bounded SD mount lock, 10 s prepare timeout
    /prepare now answers 423 before reading the body, changing state, taking the
    SD IO lock or touching USB. FatFS mount/unmount wait max 5 s for the IO lock
    instead of forever. Transmitter caps /prepare (incl. retry) at 10 s -> 504
    with a clear message; UI aborts /upload_begin after 12 s as a backstop.
2026-10-26 /prepare: reconnect USB immediately on SD lock timeout or overrun
    USB is disconnected before the SD mount. A 5 s IO-lock timeout used to fall
    back to internal flash with USB still off; now it reverts to IDLE, reconnects
    USB and answers 423. A prepare exceeding 8 s (transmitter gives up at 10 s)
    aborts the same way. Card-error retry lock wait is bounded too.
2026-10-26 Never fall back to internal flash when an SD card is the storage
    storage_manager_remount returned to flash after an SD mount failure, and
    storage_manager_init mounted flash at boot even with an SD card present, so
    fatfs_available() was true and /prepare or /clear could act on flash. Flash
    is now used only when no SD card was detected at boot; an SD mount failure
    in /prepare reconnects USB and answers 503.
2026-10-26 UI redesign stage A: theme tokens, dark top bar, strings.js
    Light/dark tokens on :root and [data-theme=dark] (and prefers-color-scheme
    when the theme is System). Dark header with logo, network chip
    (SSID from /config, devices from /status), System/Light/Dark switch
    (aria-pressed, saved in localStorage), Settings and Log out. Login page
    restyled. UI text moves to strings.js (key -> English); /strings.js route.
2026-10-26 UI redesign stage B: dashboard
    Left column: machine cards (name, Ready/Job running/Receiving/Card
    error/Offline pill, storage bar, "SD card · X free of Y"; offline cards
    greyed with last-seen age; selected = 2px accent border) and a dashed Add
    machine button. Right: selected machine card (drive state · storage ·
    firmware, pill), file row in a dashed drop zone with fit check, progress
    with big %, 12px bar and Upload/Verify/Reconnect drive/Done stepper,
    Send to <name> + Cancel. Files card: table with checkboxes, select all,
    selected rows tinted, Delete N selected and Erase all with inline
    confirmations (typed WIPE). Upload/delete/wipe logic and endpoints
    unchanged; old settings modal and ne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
2026-10-26 UI redesign stage C: messages in place of the progress area
    Icon + title + one-line why + action, never pop-ups. Busy (423): wait and
    send when idle (re-checks /status every 10 s, cancellable) or send now
    (X-Force). Too big: sizes, "delete about Z", two-part bar, jump to files.
    Card error: typed FORMAT + Format card. Done: browser-timed "X in N s"
    and Send it again to chips (busy machines disabled). Offline: last seen.
    Failed/cancelled: stopped at N%, reason, nothing changed, Try again and
    details. Messages re-render only when their content changes.
2026-10-27 UI redesign stage D: Add machine dialog and Settings page
    Add machine dialog: countdown while the transmitter listens, Stop / Look
    again, found receivers with mono ID, "check this ID matches the label",
    name, Approve and connect / Ignore; pairing file download inline with
    the Wi-Fi password warning. Dashboard notice for receivers found outside
    the window. Settings page (#settings/...): Network (router radio, router
    name/password, live router status, transmitter name/password, warning
    listing offline machines), Machines (rename/remove inline), Login and
    security, Appearance (System/Light/Dark cards), System (firmware, device
    ID, Wi-Fi devices, Recovery mode with typed RECOVERY). /status adds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
2026-10-27 transmitter: per-request httpd log (path, ms, open sockets), warn >500 ms
    Route table + dispatch trampoline; Kconfig CNC_HTTP_REQ_LOG, default on.
2026-10-27 transmitter: heartbeat replies Connection: close and frees the socket
2026-10-27 transmitter: UI as one gzipped page, versioned URL, API no-store
    web/ (login + app merged into one page) is inlined by tools/bundle_ui.py into
    one gzipped HTML (~33 KB) embedded in the app image. / -> 302 /ui/<crc>,
    served with Content-Encoding: gzip and Cache-Control max-age=1y, immutable.
    All other responses Cache-Control: no-store. SPIFFS no longer mounted.
2026-10-27 transmitter: 13 httpd sockets (lwIP 24), 5 s send/recv timeouts
    LRU purge kept. Stalled clients now free httpd within ~15 s instead of
    retrying forever on 30 s timeouts.
2026-10-27 UI: offer an 8.3 short name for long/spaced names; accept .rd and .dst
    Some controllers (e.g. Ruida lasers) only read DOS 8.3 names. When the chosen
    file isn't one, the transfer card suggests an editable short name (e.g.
    SIGN01.RD, numbered past names already on the drive); the user can keep the
    long name. Receiver already accepts both.
2026-10-27 Rename product to FileXfer (FILEXFER), v1.5.0
    - UI name and page titles FileXfer.
    - Receiver USB product string FileXfer (VID/PID and vendor unchanged); /format
    labels the volume FILEXFER.
    - Transmitter out-of-box AP SSID FILEXFER-<last 4 AP MAC hex>; factory/recovery
    SSID unchanged. mDNS filexfer.local, cnc-transfer.local kept as alias.
    - Both firmware versions 1.5.0.
2026-10-27 receiver: USB manufacturer and SCSI vendor FileXfer; CLAUDE.md SSID rule
    VID/PID unchanged.
2026-10-27 transmitter: pin AP SSID/password in NVS on first use
    First boot ever: FILEXFER-<MAC> saved. Unit already run by earlier firmware
    without a saved SSID: the factory SSID it was broadcasting is saved, so this
    and future updates never rename it. Missing password: default saved.
2026-11-01 BOOT long-press reset on both boards; Settings factory reset
    - components/boot_button: debounced GPIO0 poll, fires once after a 10 s
    hold while running; press held at start ignored, shorter holds ignored.
    - LED: magenta fast blink while held, solid 2 s on fire (both boards).
    - Receiver: 10 s hold clears pairing (unchanged behaviour).
    - Transmitter: 10 s hold resets admin login to factory default only, logged.
    - POST /factory_reset {"confirm":"RESET","remove_machines"}: AP-only,
    FILEXFER-XXXX + factory password, no router, factory login; paired
    machines kept (pull new AP creds first) unless remove_machines.
    - UI Settings > System: Factory reset with typed RESET and checkbox.
    Co-Authore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
2026-11-01 UI: show/hide toggle on password fields; any 401 signs out
    - Eye / eye-off button on every password input (aria-label, aria-pressed,
    44 px target), reset to hidden on submit.
    - fetch wrapper: any 401 clears the token and returns to login with
    "You were signed out. Log in again." (status/receivers polls need auth,
    so a BOOT login reset is noticed within one poll). Factory reset keeps
    its own message.
2026-11-09 hw: FileXfer PCB stage 1 requirements and pin map
2026-11-09 hw: FileXfer PCB stage 2 part shortlist and BOM cost
2026-11-09 hw: FileXfer PCB stage 3 schematic (ERC 0 errors) and pre-check notes
    Schematic generated by tools/gen_sch.py from KiCad stock symbols.
    Remaining ERC warnings: custom footprints for the XKB USB-A plug and
    SHOU HAN TF PUSH socket not yet drawn.
2026-11-09 hw: FileXfer PCB stage 3 ERC clean: custom footprints, board_config.h proposal
    ERC 0 errors / 0 warnings. Footprints for the XKB U217 USB-A plug and
    SHOU HAN TF PUSH microSD from vendor drawings (tools/gen_fp.py).
2026-11-09 hw: FileXfer PCB stage 4 pre-checks: LV1T125 LED buffer, Espressif module footprint, XKB edge
    - LED buffer SN74AHCT1G125 -> SN74LV1T125 (VCC 1.6-5.5 V)
    - U4 uses Espressif ESP32-S3-MINI-1 footprint (pads = stock, correct outline/keepout)
    - XKB footprint: board edge from EasyEDA footprint; Molex alternate dropped
    - ERC 0/0
2026-11-09 hw: FileXfer PCB stage 4 placement (unrouted), renders
    Board 18.3 x 64.2 mm, 2-layer; plug -> power/LED -> buttons/TC2030 -> SD
    (side slot) -> module, antenna overhangs 5.1 mm. Plug-shell notch reserve
    as a rule area. C7 10u moved to 0402. Placement DRC clean (unrouted only).
2026-11-09 hw: FileXfer PCB stage 4 routing (DRC 0 errors / 0 unconnected), renders
    - tools/route.py: scripted USB pair (0.5/0.15/0.2 -> ~91 ohm, tools/zdiff.py),
    SD fan, SD switch group, front-module trunks; A* maze router for the rest;
    GND fanout, stitching, pours both layers, island vias
    - TC2030 dropped; bottom test pads are the pogo target
    - SDMMC remapped to module-edge order (IO10-IO16), SD_PWR_EN -> IO35;
    board_config.h updated
    - U6 QOD tied to VOUT (R24 removed), C14 0402, R3/R6/R7/C10/R8/R4/C9/TP10 moved
    - docs: routing notes, case features (SD sealed, retaining rib), rev B ideas
2026-11-10 hw: FileXfer PCB pre-fab review fixes: no via-in-pad, 0402 thermal reliefs, full LCSC BOM
    - route.py: same-net SMD pads block vias; scripted escapes for U3.6/U3.2/U1.2 and
    BOOT front link; TP5 moved under SW1.1; 0402 GND pads keep spokes unless
    kicad-cli DRC reports them starved (fix_starved)
    - gen_sch.py: MPN + LCSC for all passives; U4 note 'ESP32-S3-MINI-1-N8 only
    (IO35 used; no PSRAM variants)'
    - docs: TPS22917 CT-to-VIN confirmed (VCT 7 V rating), review findings
    - DRC 0 errors / 0 unconnected / 0 parity, ERC 0
2026-11-10 hw: FileXfer PCB rev A archived: LDO tab spreader, fab files, before-ordering checklist
    - route.py: 3V3_LDO heat spreader around U2 tab (both layers, 4 thermal vias),
    other nets kept out; TP2 moved; GND corridor kept along -x edge
    - tools/gen_fab.py: gerbers/drill/zip + JLC BOM/CPL for RX and TX builds
    (J1 plug DNP) into fab/rev-A; gerbers checked (analyzer + raster)
    - docs: SD socket confirmed push-push (drawing Rev A), LDO temp re-estimate,
    order-time rails note (mouse-bites, not V-cut), before-ordering checklist,
    firmware backlog: TX reads BOARD_ID; SDMMC/SD_PWR pins updated
    - DRC 0 errors / 0 unconnected / 0 parity, ERC 0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
2026-11-10 docs: backlog #7 wording (TX ignores BOARD_ID, no check); committed .kicad_pcb is master
2026-11-10 hw: mitre track corners in place (tools/miter.py); regen fab files
    - 30 right-angle bends -> 45° mitres, 2 short Z-jogs -> single 45° diagonal;
    3 pad-centre joins left (pad copper covers the corner)
    - no reroute; parts, vias, pads, USB D+/D- unchanged; zones refilled
    - DRC 0 errors / 0 unconnected / 0 parity; gerbers re-checked (0 findings)
    - gen_fab.py no longer deletes README.md / gerber-check.png
2026-11-10 hw: schematic cleanup to block layout (no electrical change)
    - A3 single sheet, titled functional blocks (USB input, 3.3 V supply, LED +
    shifter, reset/boot/board ID, module, microSD RX-only, test pads, notes)
    - left-to-right flow, supplies up / GND down, wires inside blocks, labels
    between blocks, T-junctions only, 1.27 mm grid, decoupling at its pins,
    per-block design notes, filled title block
    - sheet-local power symbols (project lib filexfer_power) keep /GND, /+3V3,
    /+5V net names; one sheet keeps all net names
    - tools/sch_layout.py traces the drawing against PARTS before writing;
    gen_sch.py now needs --force (.kicad_sch is master); tools/netlist_cmp.py
    - netlist before/after id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
2026-11-10 docs: rev B (short case) Stage A feasibility report + placement sketch
2026-11-10 hw: rev B schematic (short case): TLV76733, USBLC6-2P6, SC-70 buffer, RN1; drop SW2, R12-R17, C1/C2/R3
    Netlist diff vs rev A shows only the approved changes; ERC 0. U3/C5 kept
    (TLV767 0.5 ms soft-start alone fails the 50 uC inrush check). Placement
    blocked on front-zone area; options in docs/revB-notes.md.
2026-11-10 hw: rev B placement (short case): SW1 + J3 on the bottom (hand-soldered, DNP), 18.3 x 31.9 mm
    Placement only, no tracks. Courtyard fill: front zone 54 % (+x half 66 %).
    DRC: 0 courtyard/edge errors; 2 expected npth_inside_courtyard (J3 pegs under U4).
    gen_fab: J3/SW1 always DNP, output to fab/rev-B. Notes: revB-notes.md section 3.
2026-11-10 hw: rev B placement corrections + J3 peg DRC exclusions; case notes; 2-layer routing attempt fails criteria
    - R1/R2 rot 270, F1 rot 270 (+5V pad inboard), R11 to the -x strip at pin 31.
    - J3 pegs: Ø0.80 per drawing, >= 0.9 mm from module pads; DRC exclusions written by gen_pcb.
    - Case: sealed card (solid -x wall + rib y 16-28), inner length 38-39, W >= 18.85, slot >= 13.1,
    BOOT floor pinhole + boss (+4.8, 8.4), LED light guide (-3.3, 8.25) 3.2 deep.
    - 2-layer routing: SD escape and +x strip via room block it; criteria not met. 4-layer proposed
    (revB-notes 3b). Board stays placement-only; tools/route.py rev B draft not committed.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
2026-11-10 hw: rev B 2-layer pass 2: +3 mm board, board-ID divider removed (rev in NVS), JLC 0.45/0.2 vias
    All nets routed, DRC 0 errors; 6 GND pour pockets remain unstitched
    (C7.2/U4.63, C15.2, J3 shield, U6.2, R9.2, TP2) - see revB-notes 3c.
2026-11-10 hw: rev B 2-layer pass 3: all GND pins on main GND, DRC 0 errors / 0 unconnected
    Drop UART/EN/+5V/USB test pads and R8 (USB download-mode flashing, Wi-Fi logs);
    RN1 reassigned to module order (pull-ups on top); C14/C15 swapped (10u at U6);
    SD_VDD crosses under the J1 pads (GND under U1->R1/R2 restored); D2 via out of
    the J3 pad; all vias tented; board_config.h rev A SD power = IO35 / pin 31.
    No 0R jumpers needed.
2026-11-10 hw: rev B review pass + fab outputs
    kicad-skill review (schematic, layout, DFM, gerbers): no blockers; findings
    triaged in revB-notes 3e (TLV76733 pins checked vs SLVSE84D). fab/rev-B from
    gen_fab.py (J1/J3/SW1 DNP) with an independent gerber raster. Before-ordering
    checklist (5), case notes for the 34.9 mm board. Backlog: TX console in
    sdkconfig.defaults, RX debug MSC+CDC build.
2026-11-10 hw: rev B STEP export with all parts (incl. DNP J1/J3/SW1)
    fab/rev-B/filexfer-revB.step via kicad-cli --subst-models. gen_fp.py writes
    placeholder STEP boxes next to the J1/J3 VRMLs, plus a WS2812B-2020 box for D2
    (no stock KiCad 10 model; gen_pcb MODEL_OVERRIDE, board model path patched,
    copper unchanged, DRC unchanged). J3 LCSC C393941 was already in the
    schematic; notes corrected.
2026-11-10 hw: rev B mitre pass in place: 21 x 90deg bends -> 45deg, acute bends removed
    tools/miter.py ported to rev B (0.127 clearance, sub-via stub cleanup, BOOT tee
    fix, edge rule vs legs). No route.py run; parts, vias, pads unchanged. USB pair
    copper identical. DRC 0/0/0, all 63 GND pads on main GND. fab/rev-B regenerated
    (gen_fab.py), gerbers re-checked, renders updated; revB-notes 3f.
