Richmond-Baah/cnc-wireless-transfer/(notices)

Notices in the files:
parts and their libraries:
ESP32-S3-MINI-1, from github.com/espressif/kicad-libraries (CC-BY-SA 4.0 with design exception). Pads checked against DS v1.7 Fig 11-1; antenna keepout 15.4 x 5.1 mm all layers
